xz-group/PiCar/hw/readme.md

The current version of the PiCar does not use a separate motor control board. 
Check documentation for hardware info.
