xz-group/PiCar/src/readme.md

# src - source code

The directory is broadly classified into the following categories:
- arduino
  - contains the low level motor-encoder feedback control
- data
  - contains means to log and analysize data from sensors
- mobile_movement_control
  - contains robust way of controlling the robot using WASD keys (*good place to start for first timers*)
- obsolete
  - code from previous versions of the project that may be used for reference
- pi
  - includes servo GPIO control, camera, and sensor intergration
- pi_arduino_comm
  - contains SPI, Serial and I2C protocols for Raspberry Pi and Arduino
