xz-group/PiCar/hw/chassis/README.md

This folder contains all the CAD files created or used to build the PI Car.

The list of the files are as follows: 
* Bottom Motor Holder
* Camera Post
* Chassis
* Encoder Holder
* Second Level
* Top Motor Holder

Editable .step files can be accessed through GrabCAD (https://grabcad.com/library/pi-car-1).
