xz-group/PiCar/src/arduino_PCB/README.md

Files:
Arduino - 'main' file
LSM9DS1_Resisters, LSM9DS1_Types - LSM9DS1 (6DOF IMU) Library
avrfix, avrfix_config - AVR fixed point library
ddefs - definitions for dshare array
dshare - shared data array
fp - custom fixed point library
imu - custom imu library
servocontrol - servo control library
speed_control - speed control library
spi_comm - SPI communication library
timers - timer library
