xz-group/PiCar/hw/chassis/stl_files/readme.txt

.STL files

These files can be uploaded into a slicing software such as Cura to be 3D printed. 
Files cannot be edited. Send e-mail to wluer@wustl.edu if you would like to receive access to an editable version.
