xz-group/PiCar/docs/readthedocs/index.rst

.. PiCar documentation master file, created by
   sphinx-quickstart on Sat May 19 23:21:28 2018.
   You can adapt this file completely to your liking, but it should at least
   contain the root `toctree` directive.

PiCar Documentation
=================================

PiCar
    A multi-purpose, robotic, lab-scale, open-source, wheeled, autonomous
    research platform created at Washington University in St. Louis

Click on ``Getting Started`` tab on the sidebar, use the search-bar or use any of
the following links to get started.

.. toctree::
   :maxdepth: 3

   chapters/introduction
   chapters/tutorials
   chapters/usage
   chapters/results
   chapters/changelogs
   chapters/contributors
