xz-group/PiCar/hw/motorcontrol/v1.0/README.md

Go to [https://github.com/hgonzale/PiCar/wiki/Breakout-Board](https://github.com/hgonzale/PiCar/wiki/Breakout-Board) for the Breakout Board wiki.
