xz-group/PiCar/src/obsolete/IMU Programs/README

* Developed by Mark Williams
* Created Decemeber 2014 - Updated May 2016

This program will enable your Raspberry Pi to read the values from a gyroscope, accelerometer & magnetometer and convert them to usable angles and heading.
It also includes tilt compensation for compass heading. Utilises both the Complementary and Kalman filters.
Go here for more information;

http://ozzmaker.com/

Run with:
sudo python berryIMU.py

/home/pi/IMU Programs/BerryIMU/python-BerryIMU-gryo-accel-compass/

python berryIMU.py
or python berryIMU-simple.py
