xz-group/PiCar/hw/motorcontrol/v1.0/images/README.md

This directory contains the images used for the breakout board part of the wiki.
