xz-group/PiCar/src/pi/computer_vision/OpticalFlow/videos_papers_plots/ttcPlot.png

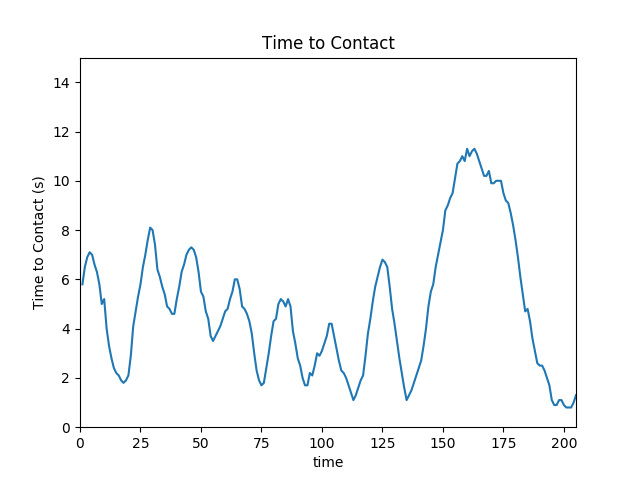
src/pi/computer_vision/OpticalFlow/videos_papers_plots/ttcPlot.png
