xz-group/PiCar/hw/chassis/step_files/Encoder Holder.step

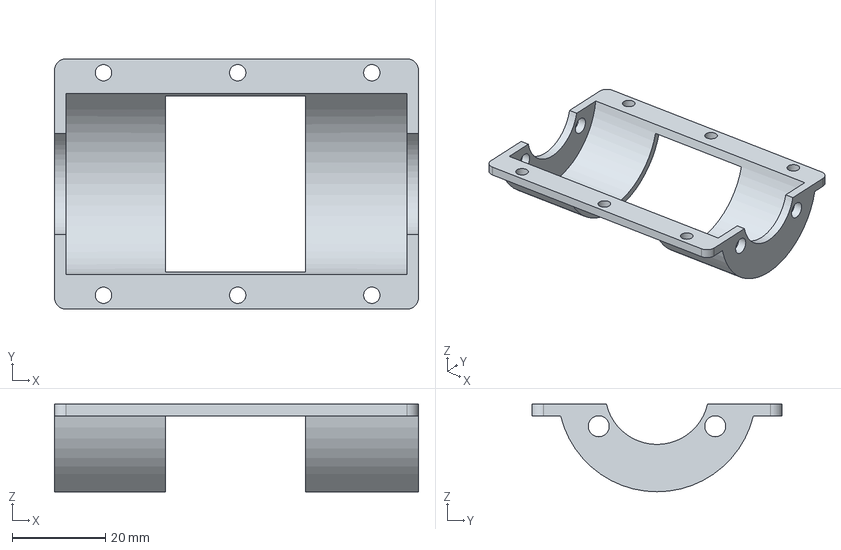
[picture p93: CAD file, 2016-12-12]
hw/chassis/step_files/Encoder Holder.step
78.0 x 53.7 x 18.8 mm
