xz-group/PiCar/hw/chassis/stl_files/Second Level.stl

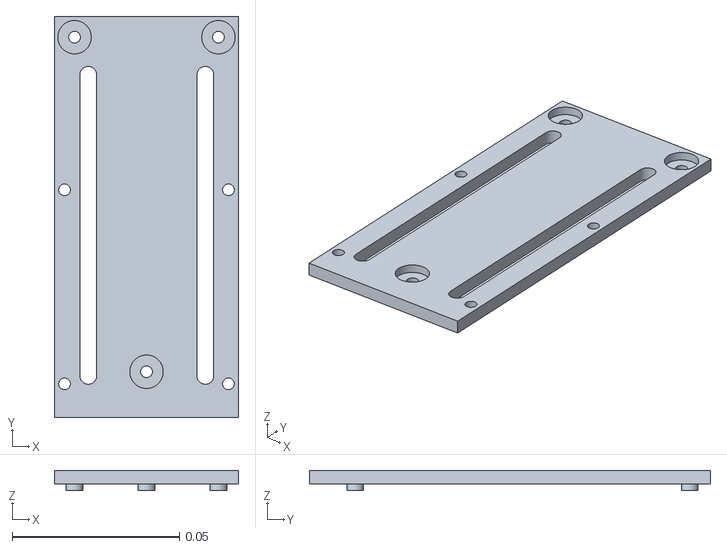
[picture p94: CAD file, 2016-12-09]
hw/chassis/stl_files/Second Level.stl
0.055 x 0.12 x 0.006
