xz-group/PiCar/hw/chassis/step_files/Second Level Plate.step

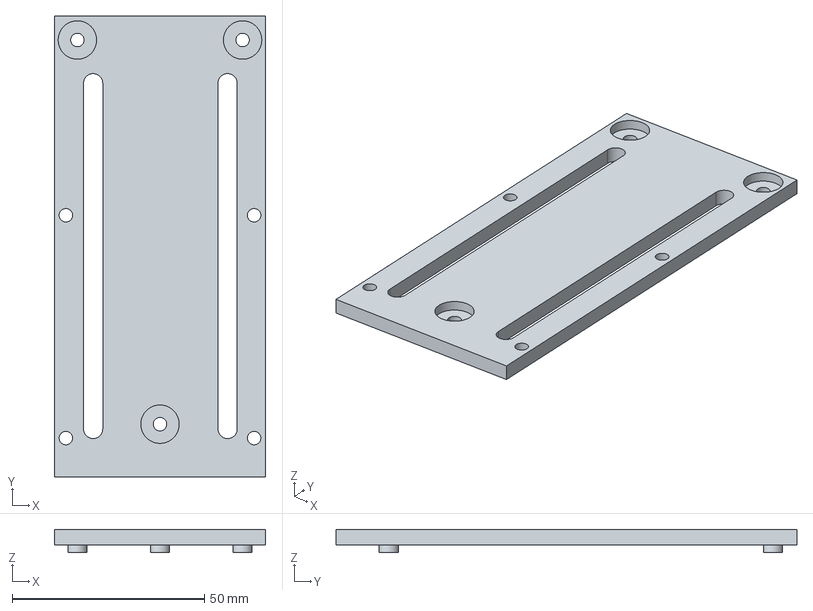
[picture p95: CAD file, 2016-12-12]
hw/chassis/step_files/Second Level Plate.step
55.0 x 120.0 x 6.00 mm
