xz-group/PiCar/hw/chassis/step_files/Bottom Motor Holder.step

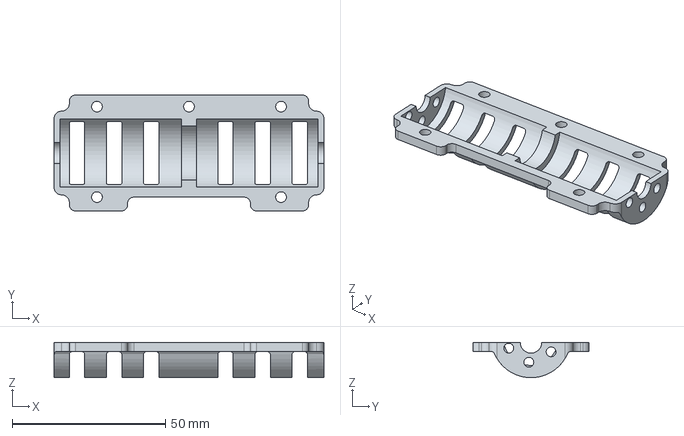
[picture p96: CAD file, 2016-12-12]
hw/chassis/step_files/Bottom Motor Holder.step
88.0 x 37.8 x 11.5 mm
