xz-group/PiCar/hw/chassis/step_files/Top Motor Holder.step

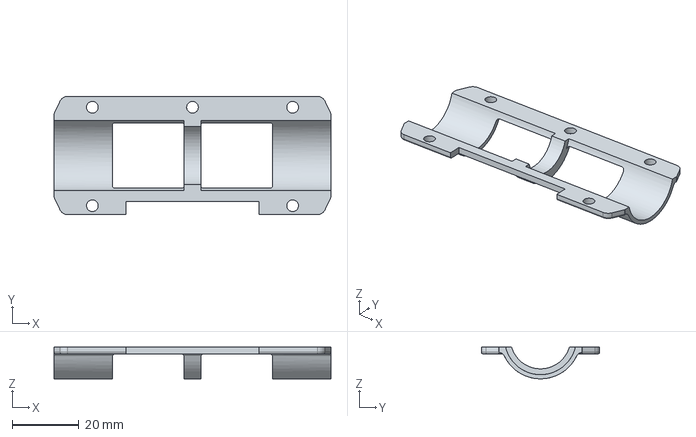
[picture p97: CAD file, 2016-12-12]
hw/chassis/step_files/Top Motor Holder.step
83.0 x 35.5 x 9.50 mm
