xz-group/PiCar/hw/chassis/step_files/Chassis.step

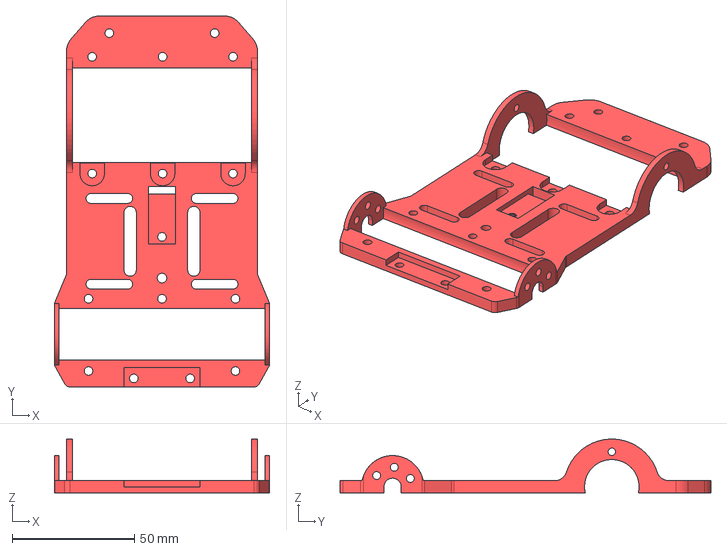
[picture p98: CAD file, 2016-12-12]
hw/chassis/step_files/Chassis.step
88.0 x 151.5 x 22.0 mm
