xz-group/PiCar/hw/chassis/step_files/Camera Post.step

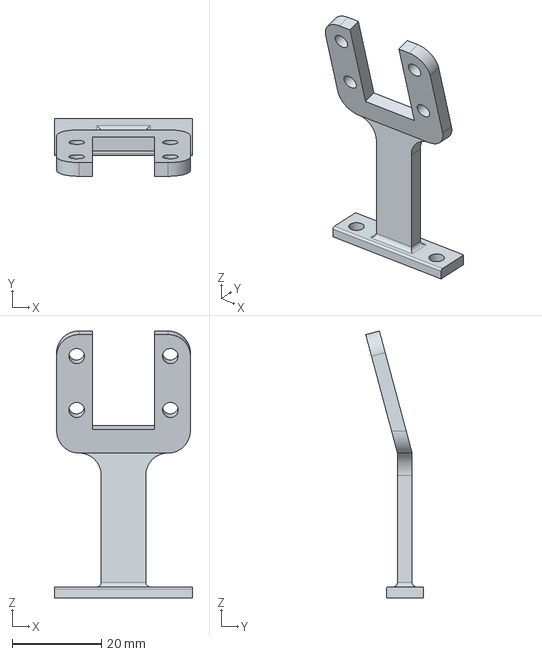
[picture p99: CAD file, 2016-12-12]
hw/chassis/step_files/Camera Post.step
31.0 x 12.9 x 59.9 mm
