xz-group/PiCar/(list of files, cad)

Other CAD files:
hw/chassis/stl_files/Bottom Motor Holder.stl
hw/chassis/stl_files/Camera Post.stl
hw/chassis/stl_files/Chassis.stl
hw/chassis/stl_files/Encoder Holder.stl
hw/chassis/stl_files/Top Motor Holder.stl
hw/obsolete/chassis/stl_files/Bottom Motor Holder.stl
hw/obsolete/chassis/stl_files/Camera Post.stl
hw/obsolete/chassis/stl_files/Chassis.stl
hw/obsolete/chassis/stl_files/Encoder Holder.stl
hw/obsolete/chassis/stl_files/Top Motor Holder.stl
