xz-group/PiCar/hw/chassis/print_screenshots/README

Screenshots of print orientation and settings used to print.
Printer type: Ultimaker Extended 2
Slicing Software: Cura 15.04.3
