xz-group/PiCar/docs/readthedocs/chapters/tutorials.rst

Tutorials
=============

To help you get acquainted with the PiCar platform, the following tutorials
will help you bring to speed about the different components used.

.. toctree::
   :maxdepth: 1

   tutorials/raspberry_pi_basics
   tutorials/arduino_basics
   tutorials/github_basics
   tutorials/linux_basics
   tutorials/python_basics
   tutorials/readthedocs_tut

.. note:: Some of the tutorials will be in the general sense of the components,
          like Linux, etc., while others will specific to the PiCar project.
