xz-group/PiCar/docs/readthedocs/chapters/usage/picar_usage.rst

The Picar Module
#######################

.. autoclass:: picar.device
   :members:

.. autoclass:: picar.sensor
    :inherited-members:

.. autoclass:: picar.pmucounter
    :inherited-members:

.. autoclass:: picar.IMU
    :inherited-members:

.. autoclass:: picar.LiDar
    :inherited-members:

.. autoclass:: picar.Camera
    :inherited-members:

.. autoclass:: picar.Timer
    :members:

.. autoclass:: picar.Killer
    :members:

.. autofunction:: picar.pre_exec

.. autofunction:: picar.filenames

.. autofunction:: picar.getCamera

.. autofunction:: picar.getSensor

.. autofunction:: picar.getSensorAndCamera
