xz-group/PiCar/docs/readthedocs/chapters/usage.rst

Usage
=============

The project is split into three parts:

.. toctree::
   :maxdepth: 2

   usage/mechanical
   usage/electronics
   usage/software
   usage/datasheet
   usage/picar_usage
