xz-group/PiCar/hw/chassis/print_screenshots/BottomMotorHolderPrintScreenshot.png

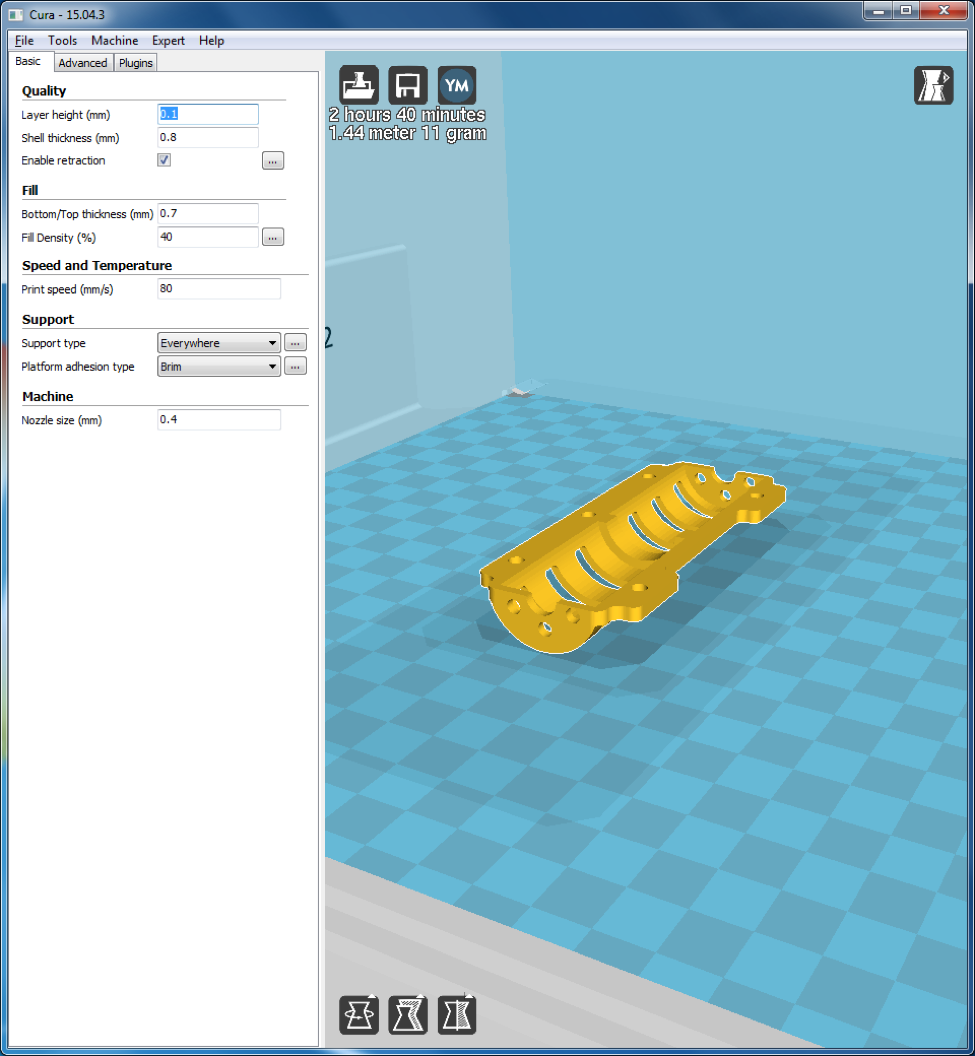
hw/chassis/print_screenshots/BottomMotorHolderPrintScreenshot.png
