xz-group/PiCar/hw/chassis/print_screenshots/CameraPostPrintScreenshot.png

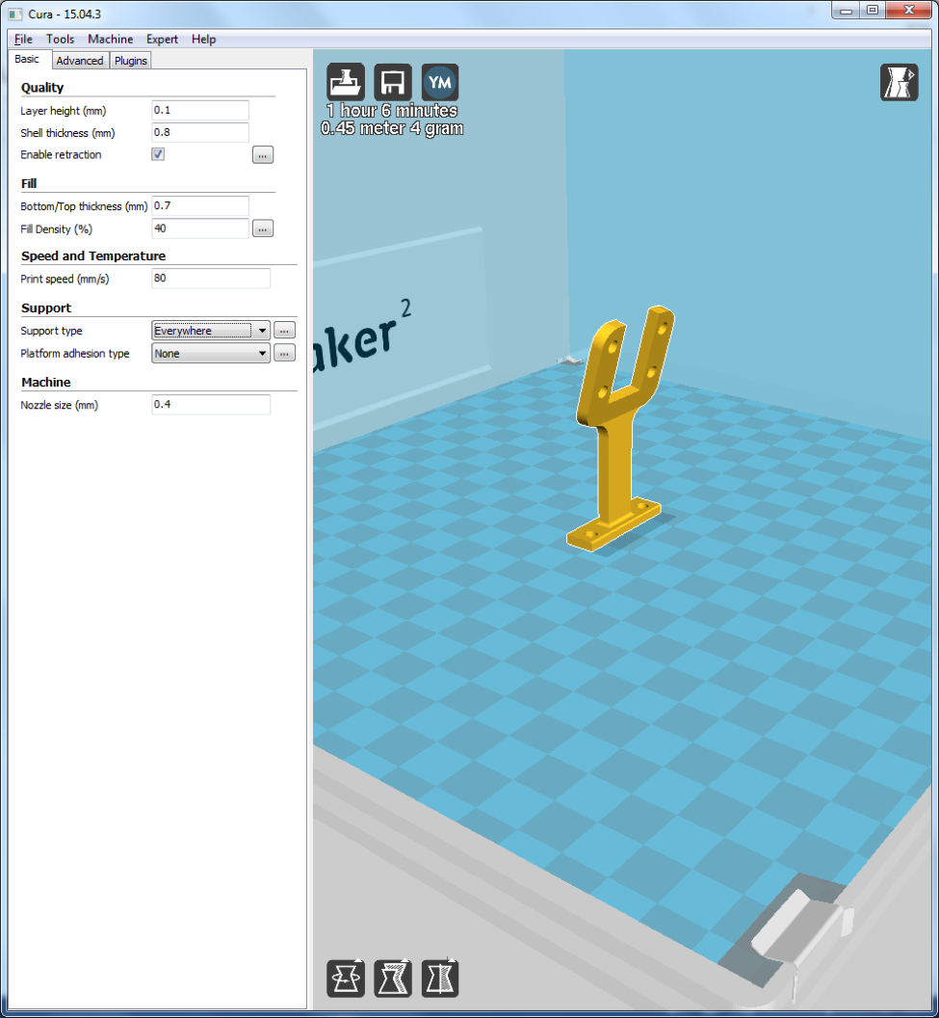
hw/chassis/print_screenshots/CameraPostPrintScreenshot.png
