xz-group/PiCar/hw/chassis/print_screenshots/ChassisPrintScreenshot.png

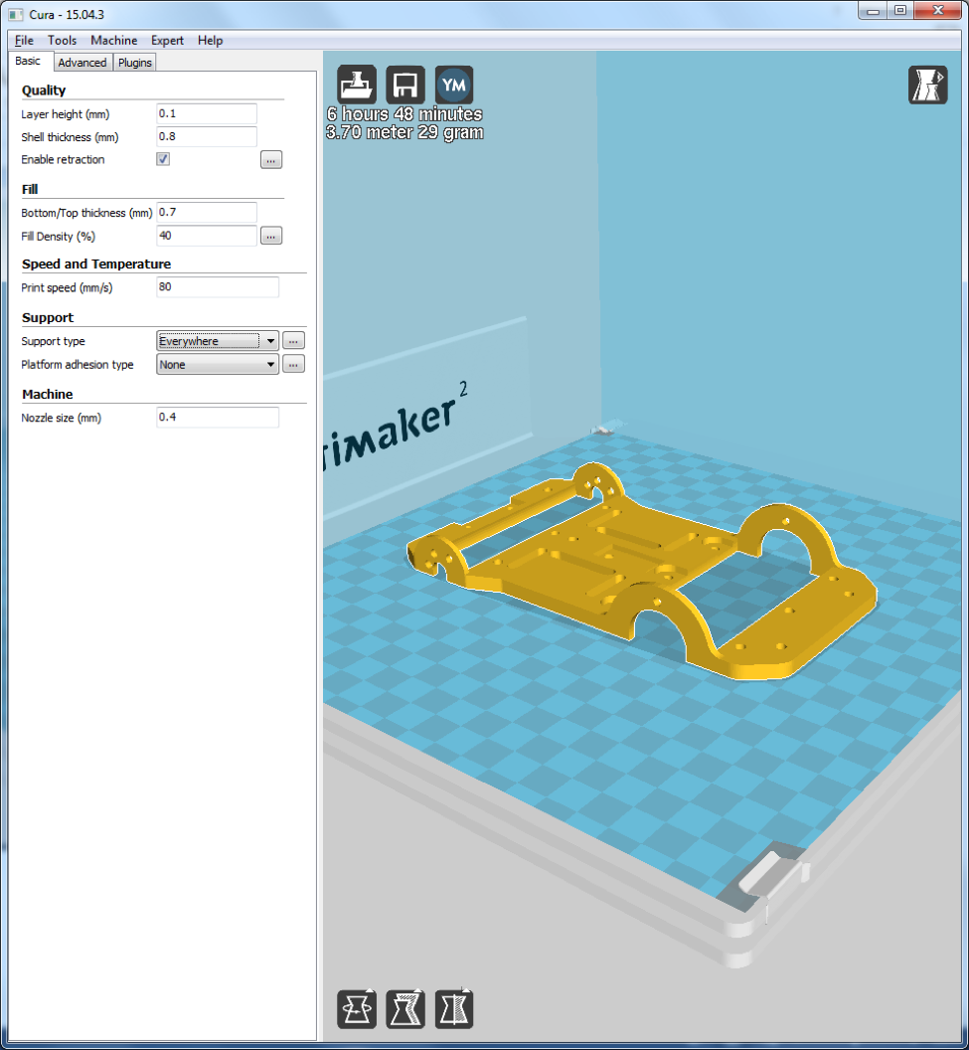
hw/chassis/print_screenshots/ChassisPrintScreenshot.png
