xz-group/PiCar/hw/chassis/print_screenshots/EncoderHolderPrintScreenshot.png

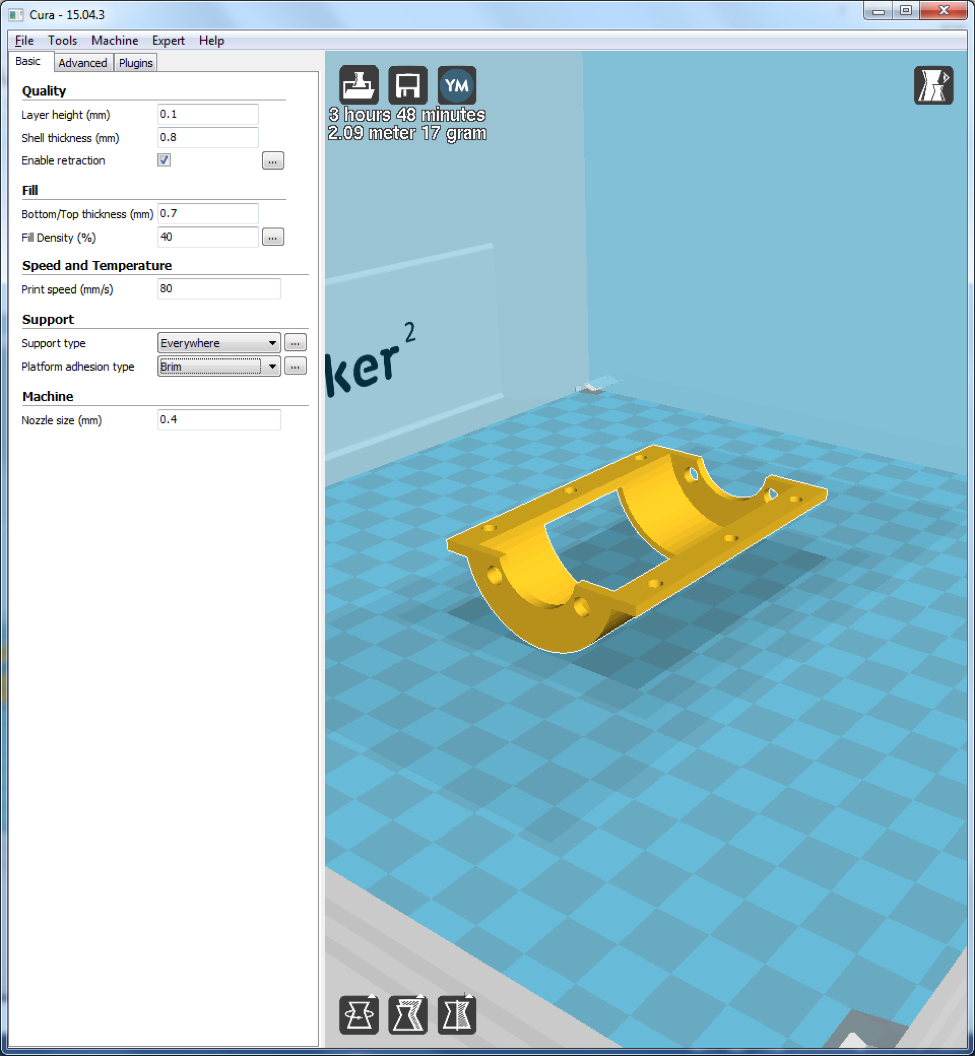
hw/chassis/print_screenshots/EncoderHolderPrintScreenshot.png
