xz-group/PiCar/hw/chassis/print_screenshots/SecondLevelPrintScreenshot.png

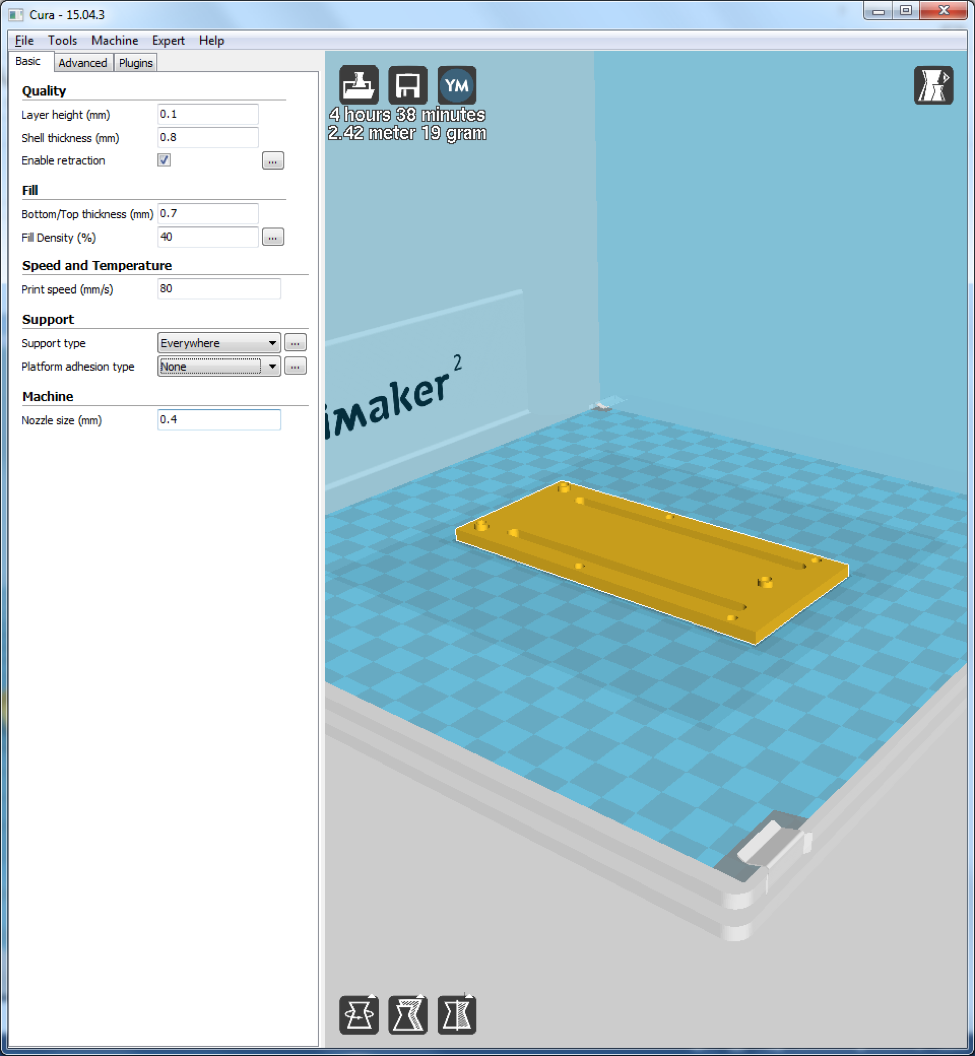
hw/chassis/print_screenshots/SecondLevelPrintScreenshot.png
