xz-group/PiCar/docs/readthedocs/chapters/results.rst

Results
=============

The PiCar platform has been used in many research project.
This page gives a comprehensive list of different results that were achieved.

.. toctree::
   :maxdepth: 1

   results/imu_autonomous_navigation
   results/power_management
   results/optical_flow
   results/mobile_movement_control
   results/obstacle_avoidance
