xz-group/PiCar/src/data/data_analysis/Display/PapaParse-4.5.0/tests/sample.csv

A | B | C
X | Y | Z
