xz-group/PiCar/src/data/data_analysis/Display/PapaParse-4.5.0/tests/verylong-sample.csv

placeholder | meaning of life | TLD
Lorem ipsum dolor sit | 42 | ABC
Etiam a dolor vitae est vestibulum | 84 | DEF
Lorem ipsum dolor sit | 42 | ABC
Etiam a dolor vitae est vestibulum | 84 | DEF
Etiam a dolor vitae est vestibulum | 84 | DEF
Lorem ipsum dolor sit | 42 | ABC
Lorem ipsum dolor sit | 42 | ABC
Etiam a dolor vitae est vestibulum | 84 | DEF
Lorem ipsum dolor sit | 42 | ABC
Etiam a dolor vitae est vestibulum | 84 | DEF
Lorem ipsum dolor sit | 42 | ABC
Etiam a dolor vitae est vestibulum | 84 | DEF
Etiam a dolor vitae est vestibulum | 84 | DEF
Lorem ipsum dolor sit | 42 | ABC
Etiam a dolor vitae est vestibulum | 84 | DEF
Lorem ipsum dolor sit | 42 | ABC
Lorem ipsum dolor sit | 42 | ABC
Etiam a dolor vitae est vestibulum | 84 | DEF
Etiam a dolor vitae est vestibulum | 84 | DEF
Lorem ipsum dolor sit | 42 | ABC
Etiam a dolor vitae est vestibulum | 84 | DEF
Etiam a dolor vitae est vestibulum | 84 | DEF
Lorem ipsum dolor sit | 42 | ABC
Etiam a dolor vitae est vestibulum | 84 | DEF
Lorem ipsum dolor sit | 42 | ABC
Lorem ipsum dolor sit | 42 | ABC
Lorem ipsum dolor sit | 42 | ABC
Etiam a dolor vitae est vestibulum | 84 | DEF
Etiam a dolor vitae est vestibulum | 84 | DEF
Etiam a dolor vitae est vestibulum | 84 | DEF
Etiam a dolor vitae est vestibulum | 84 | DEF
Etiam a dolor vitae est vestibulum | 84 | DEF
Lorem ipsum dolor sit | 42 | ABC
Lorem ipsum dolor sit | 42 | ABC
Lorem ipsum dolor sit | 42 | ABC
Etiam a dolor vitae est vestibulum | 84 | DEF
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
Lorem ipsum dolor sit | 42 | ABC
Lorem ipsum dolor sit | 42 | ABC
Etiam a dolor vitae est vestibulum | 84 | DEF
Lorem ipsum dolor sit | 42 | ABC
Lorem ipsum dolor sit | 42 | ABC
Etiam a dolor vitae est vestibulum | 84 | DEF
Lorem ipsum dolor sit | 42
Lorem ipsum dolor sit | 42 | ABC
