xz-group/PiCar/docs/readthedocs/chapters/changelogs.rst

Changelogs
=============

v2.0 (`latest <https://github.com/xz-group/PiCar>`_)
  * Changed chassis design to make PiCar more robust
  * Added single encoder with DC motor for closed loop
  * Incorporated LIDAR and IMU
  * Added comprehensive ReadtheDocs documentation

v1.0 (`Github <https://github.com/xz-group/PiCar/tree/v1.0>`_)
  * Designed and built entirely 3D printable chassis
  * Used brushless DC motor, ESC and servo for steering and driving
  * Designed and assembled PCB for power management, reading hall effect
    sensors and IMU data
  * Used camera with optical flow computer vision algorithm for tracking
