xz-group/PiCar/hw/motorcontrol/v2.1/motorcontrol-diagrams.pdf

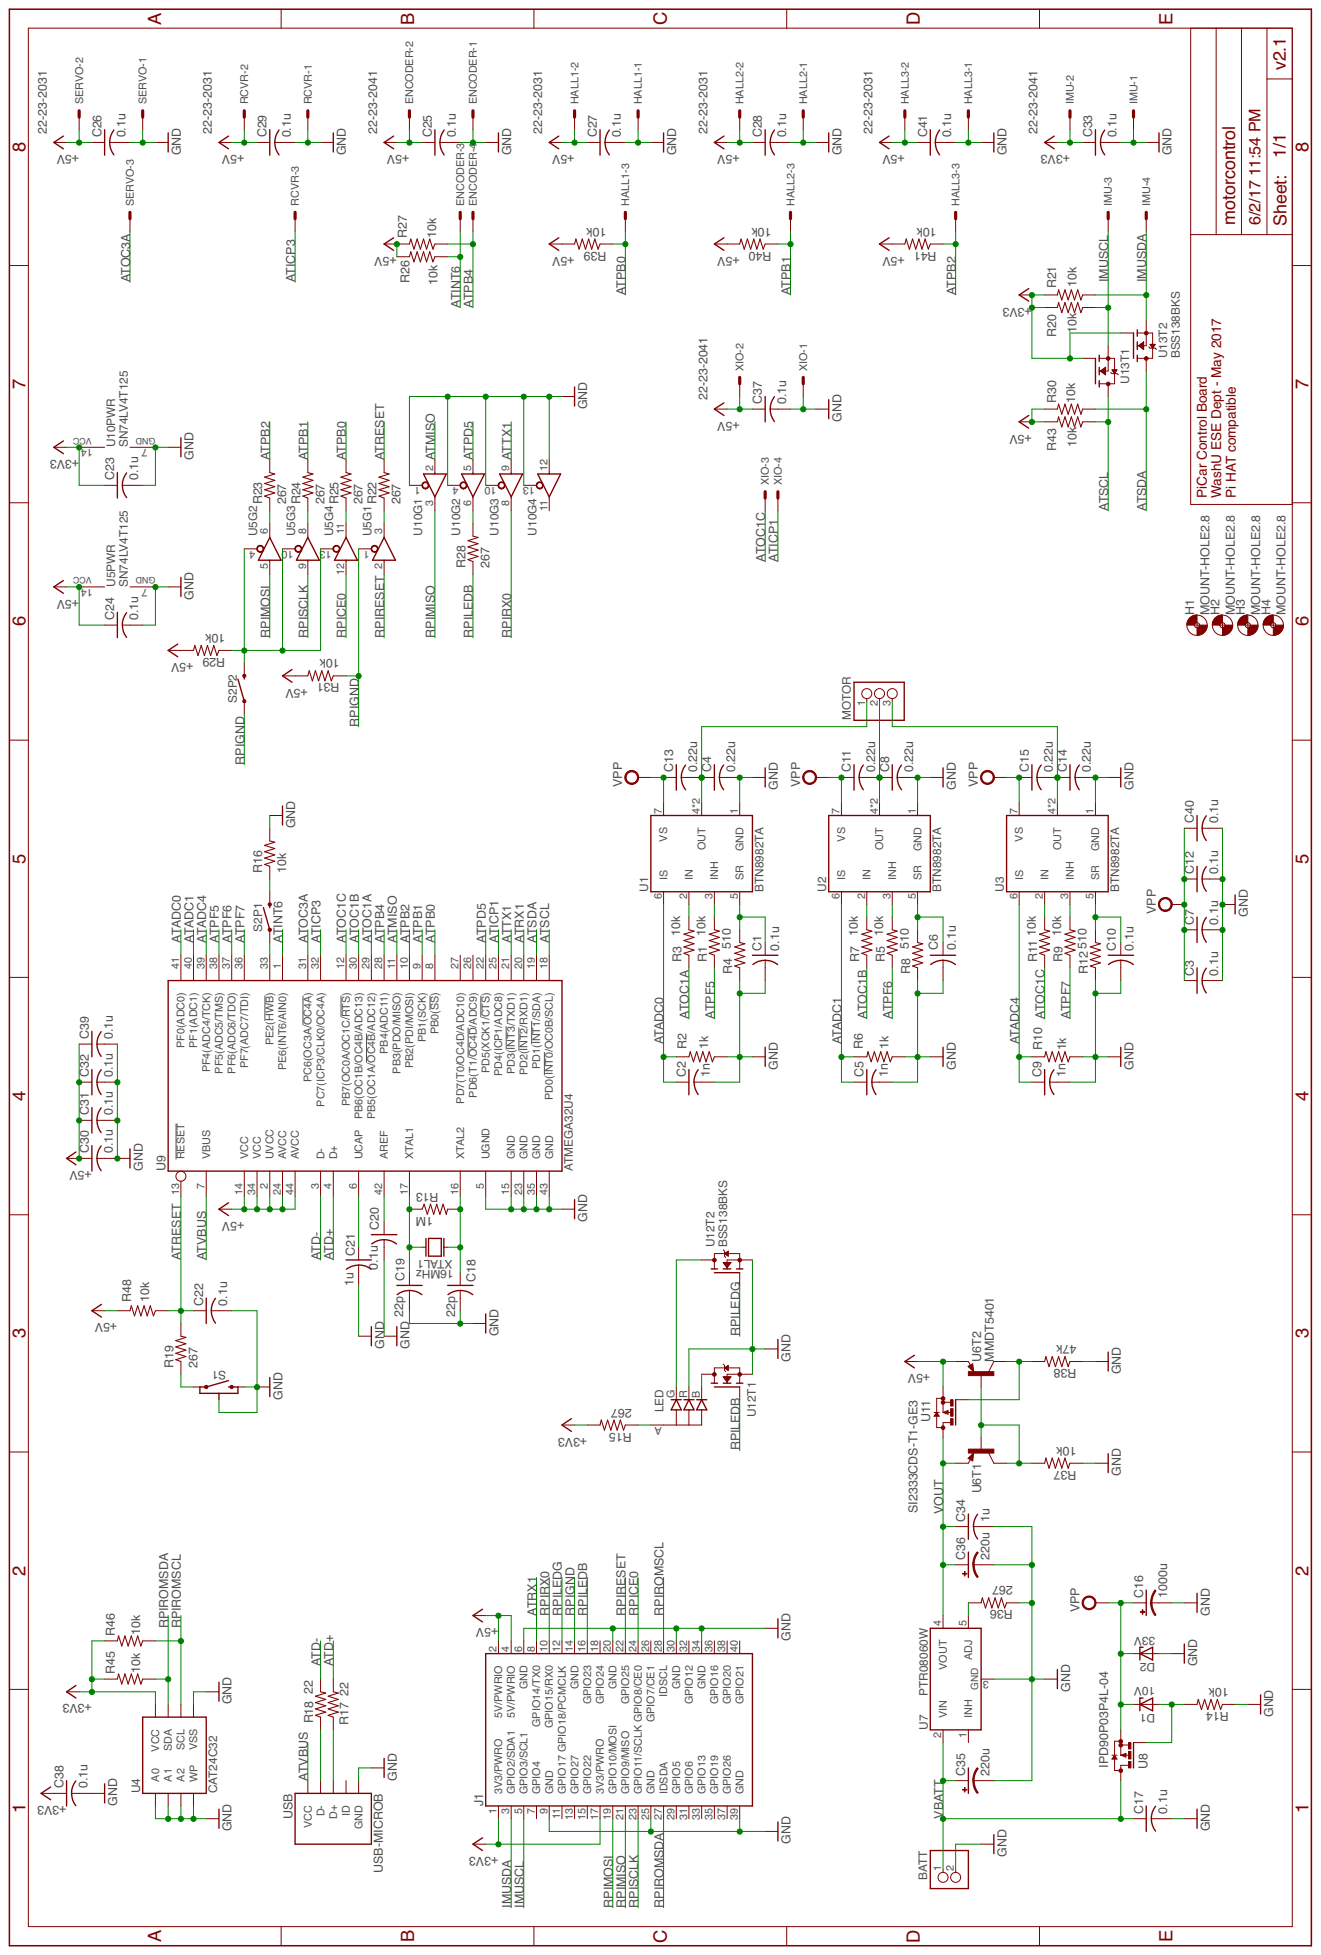
[picture p106: page 1]

PiCar Control Board WashU ESE Dept - May 2017 Pi HAT compatible v2.1 motorcontrol 6/2/17 11:54 PM

MOUNT-HOLE2.8 MOUNT-HOLE2.8

PF0(ADC0) 41 PF1(ADC1) 40 PF4(ADC4/TCK) 39 PF5(ADC5/TMS) 38 PF6(ADC6/TDO) 37 PF7(ADC7/TDI) 36 PE6(INT6/AIN0) 1

PB3(PDO/MISO) 11 PB2(PDI/MOSI) 10 PB1(SCK) 9 PB0(SS) 8 PD7(T0/OC4D/ADC10) 27 PD6(T1/OC4D/ADC9) 26 PD5(XCK1/CTS) 22 PD4(ICP1/ADC8) 25 PD3(INT3/TXD1) 21 PD2(INT2/RXD1) 20 PD1(INT1/SDA) 19 PD0(INT0/OC0B/SCL) 18

ATD- ATD- ATD+ ATD+

VCC A0A1A2 SCL WP VSS

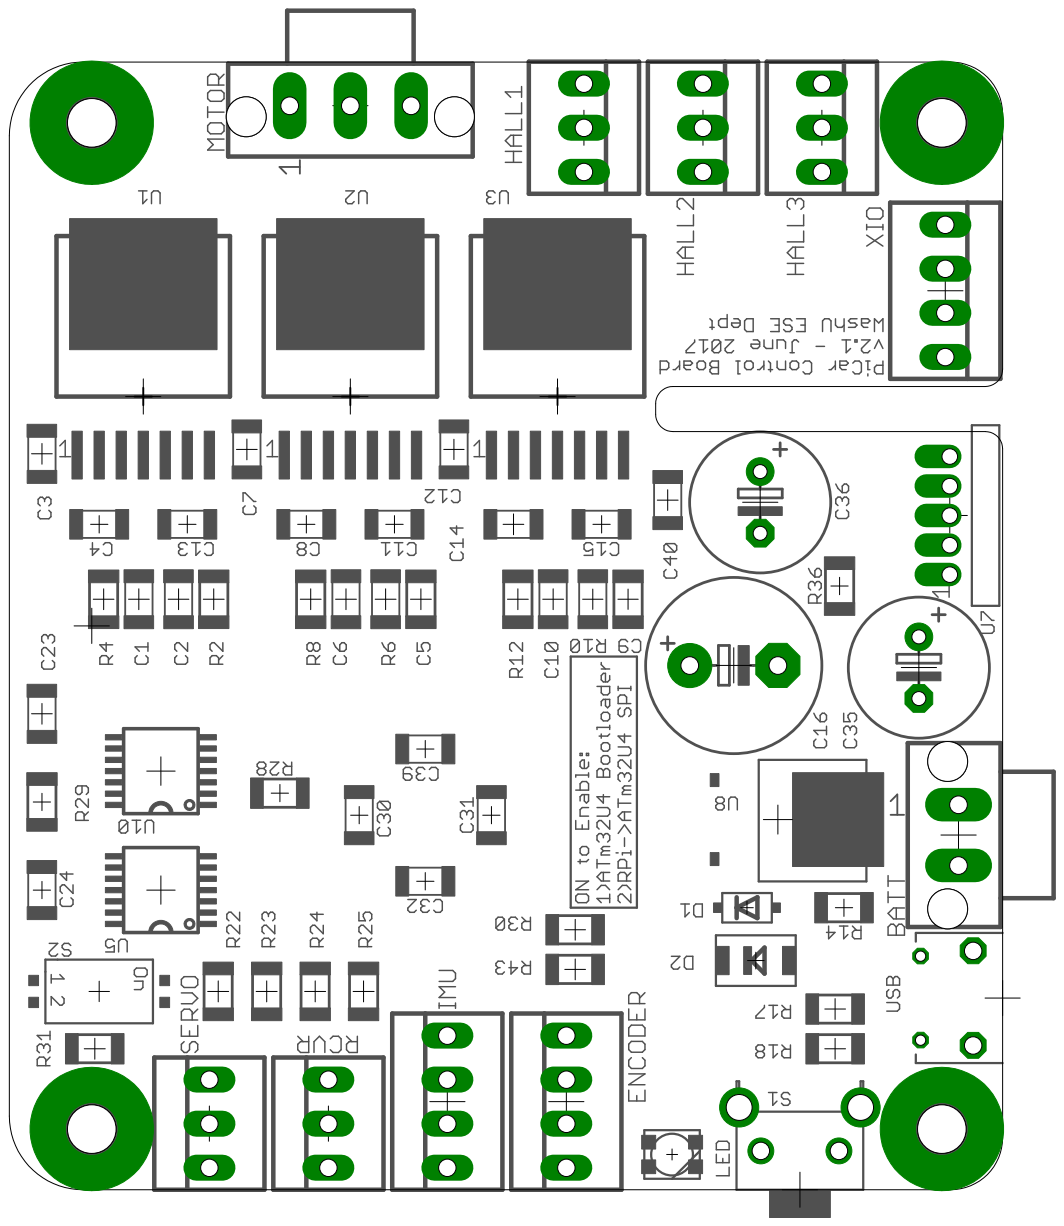
[picture p107: page 2]

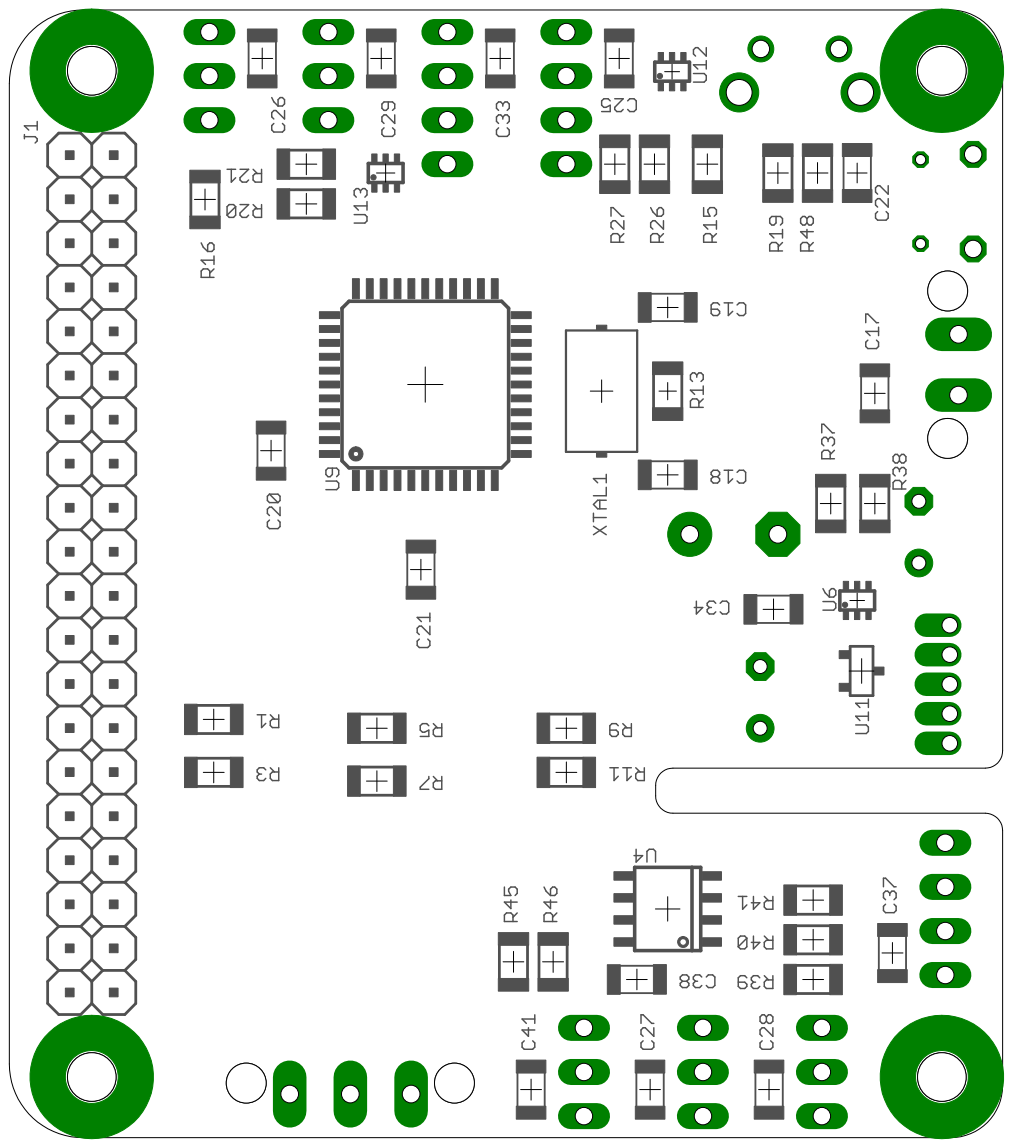
[picture p108: page 3]
