xz-group/PiCar/hw/motorcontrol/v2.0/sch.pdf

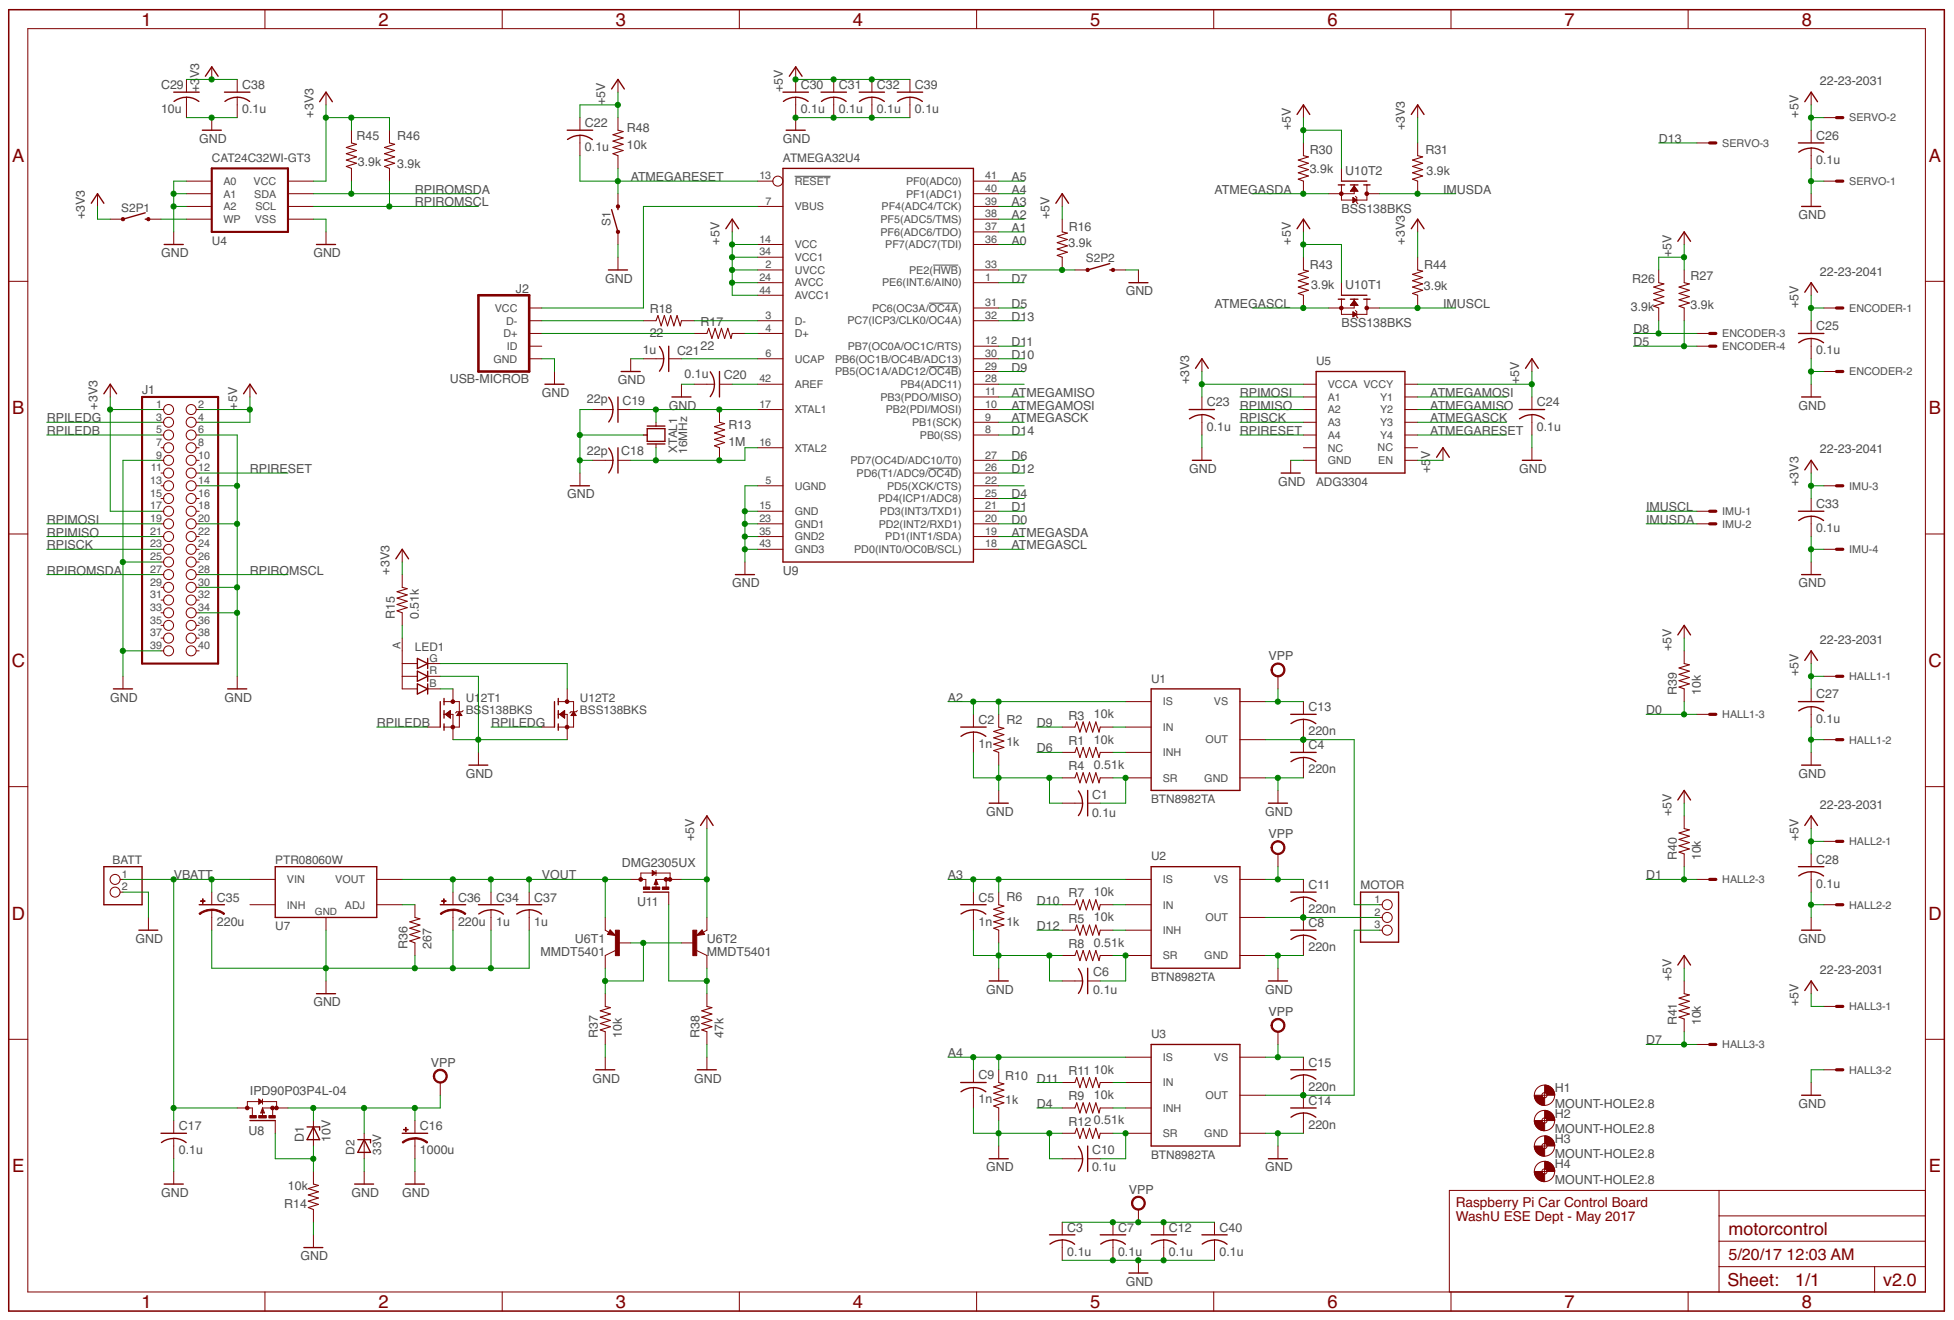
[picture p109: page 1]

Raspberry Pi Car Control Board
WashU ESE Dept - May 2017
