xz-group/PiCar/hw/motorcontrol/v2.0/brd_bottom.pdf

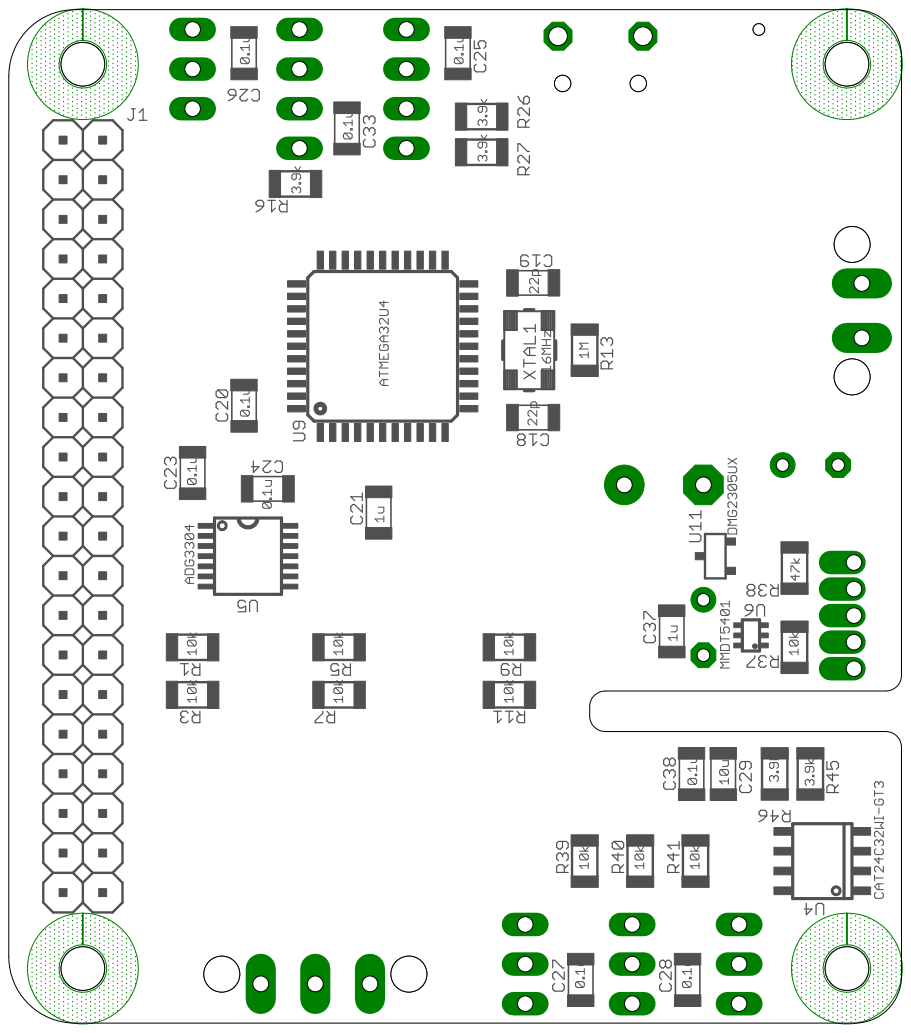
[picture p110: page 1]
