xz-group/PiCar/hw/motorcontrol/v2.0/brd_top.pdf

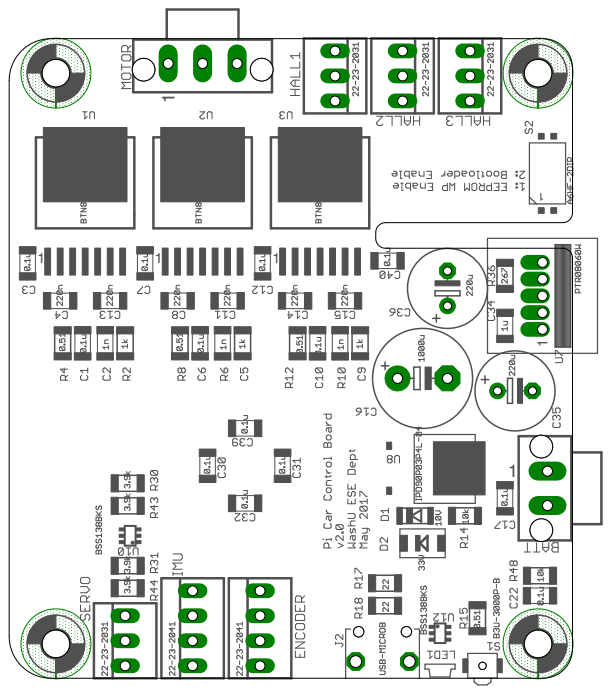
[picture p111: page 1]
