xz-group/PiCar/hw/motorcontrol/v2.1/motorcontrol.brd

## EAGLE design hw/motorcontrol/v2.1/motorcontrol.brd (2018-01-17)

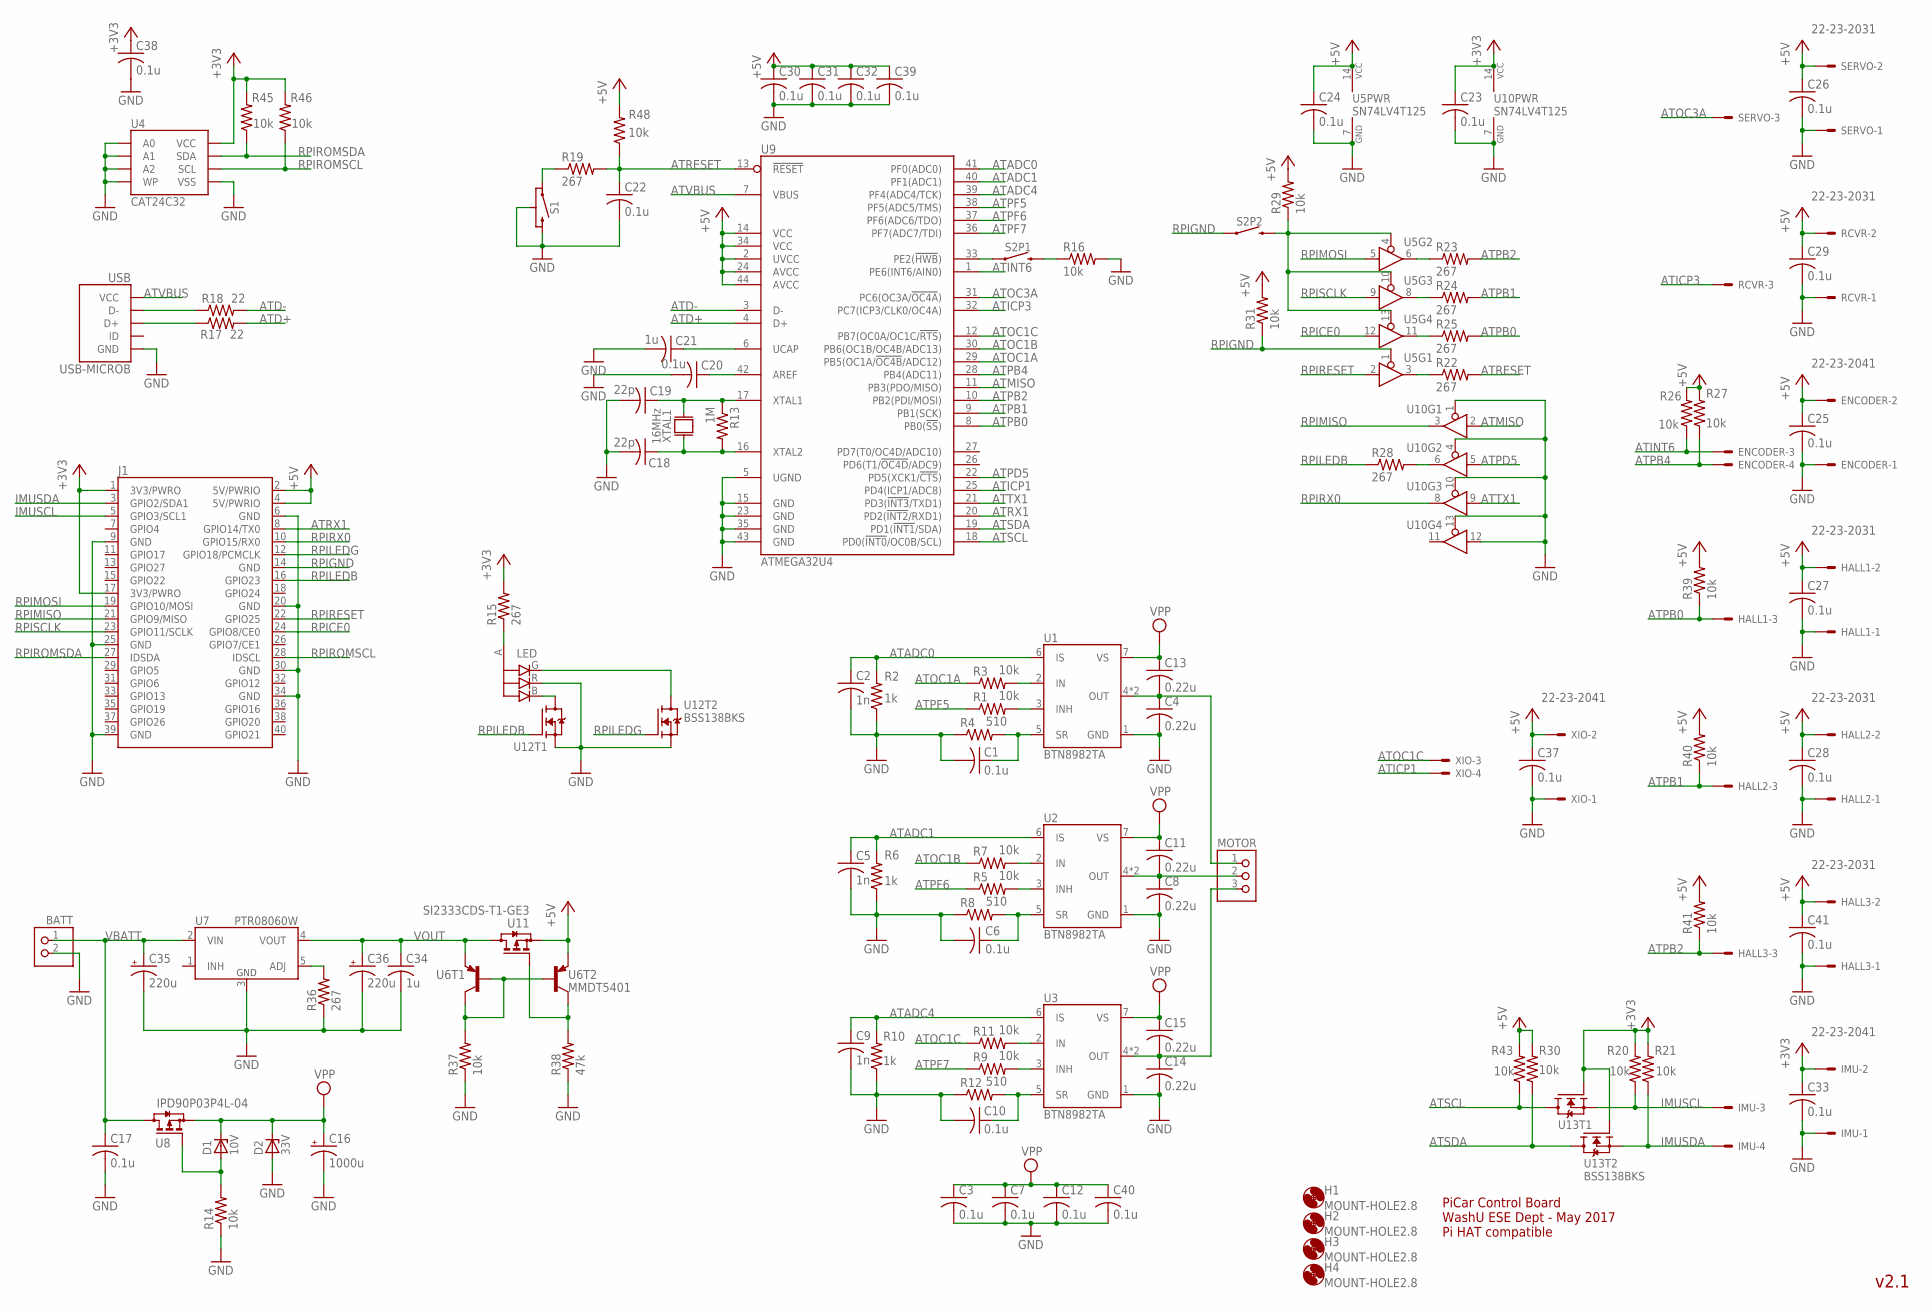
[picture p112: schematic motorcontrol.sch]

Parts:
BATT: ULTRAFIT_2CIRCVCLIP; ULTRAFIT_2CIRC_VERTCLIP
C1, C3, C6, C7, C10, C12, C17, C20, C22, C23, C24, C25, C26, C27, C28, C29, C30, C31, C32, C33, C37, C38, C39, C40, C41: 0.1u; C1206
C2, C5, C9: 1n; C1206
C4, C8, C11, C13, C14, C15: 0.22u; C1206
C16: 1000u; E5-10,5
C18, C19: 22p; C1206
C21, C34: 1u; C1206
C35, C36: 220u; E3,5-8
D1: 10V; SOD123
D2: 33V; SMA
ENCODER: 22-23-2041
H1, H2, H3, H4: MOUNT-HOLE2.8; 2,8
HALL1, HALL2, HALL3: 22-23-2031
IMU: 22-23-2041
J1: RPIHEADER_2.54-SMD; RPI_SMD
LED: LED_3COLOR_COMMONA1411; 150141M173100
MOTOR: ULTRAFIT_3CIRCVCLIP; ULTRAFIT_3CIRC_VERTCLIP
R1, R3, R5, R7, R9, R11, R14, R16, R20, R21, R26, R27, R29, R30, R31, R37, R39, R40, R41, R43, R45, R46, R48: 10k; R1206
R2, R6, R10: 1k; R1206
R4, R8, R12: 510; R1206
R13: 1M; R1206
R15, R19, R22, R23, R24, R25, R28, R36: 267; R1206
R17, R18: 22; R1206
R38: 47k; R1206
RCVR: 22-23-2031
S1: SWITCH-GND; B3F-312X
S2: A6HF-2DIP
SERVO: 22-23-2031
U1, U2, U3: BTN8982TA; TO263-7
U4: CAT24C32; SOIC8
U5, U10: SN74LV4T125; TSSOP14
U6: MMDT5401; SOT363
U7: PTR08060W; EDP_MODULE
U8: IPD90P03P4L-04; TO252-3-11
U9: ATMEGA32U4; TQFP44
U11: SI2333CDS-T1-GE3; SOT23-3
U12, U13: BSS138BKS; SOT363
USB: USB-MICROB; FCI-10103594-0001LF
XIO: 22-23-2041
XTAL1: 16MHz; ABLS7M2

Connections:
+3V3: C23.1, C33.1, C38.1, IMU.2, J1.1 (3V3/PWRO), J1.17 (3V3/PWRO), R15.2, R20.2, R21.2, R45.2, R46.2, U4.8 (VCC), U10.14 (VCC), U13.2 (G), U13.5 (G)
+5V: C24.1, C25.1, C26.1, C27.1, C28.1, C29.1, C30.1, C31.1, C32.1, C37.1, C39.1, C41.1, ENCODER.2, HALL1.2, HALL2.2, HALL3.2, J1.2 (5V/PWRIO), J1.4 (5V/PWRIO), R26.2, R27.2, R29.2, R30.2, R31.2, R39.2, R40.2, R41.2, R43.2, R48.2, RCVR.2, SERVO.2, U5.14 (VCC), U6.4 (E), U9.2 (UVCC), U9.14 (VCC), U9.24 (AVCC), U9.34 (VCC), U9.44 (AVCC), U11.2 (S), XIO.2
ATADC0: C2.1, R2.2, U1.6 (IS), U9.41 (PF0(ADC0))
ATADC1: C5.1, R6.2, U2.6 (IS), U9.40 (PF1(ADC1))
ATADC4: C9.1, R10.2, U3.6 (IS), U9.39 (PF4(ADC4/TCK))
ATD+: R17.2, U9.4 (D+)
ATD-: R18.2, U9.3 (D-)
ATICP1: U9.25 (PD4(ICP1/ADC8)), XIO.4
ATICP3: RCVR.3, U9.32 (PC7(ICP3/CLK0/OC4A))
ATINT6: ENCODER.3, R26.1, U9.1 (PE6(INT6/AIN0))
ATMISO: U9.11 (PB3(PDO/MISO)), U10.2 (I)
ATOC1A: R3.1, U9.29 (PB5(OC1A/!OC4B!/ADC12))
ATOC1B: R7.1, U9.30 (PB6(OC1B/OC4B/ADC13))
ATOC1C: R11.1, U9.12 (PB7(OC0A/OC1C/!RTS!)), XIO.3
ATOC3A: SERVO.3, U9.31 (PC6(OC3A/!OC4A!))
ATPB0: HALL1.3, R25.2, R39.1, U9.8 (PB0(!SS!))
ATPB1: HALL2.3, R24.2, R40.1, U9.9 (PB1(SCK))
ATPB2: HALL3.3, R23.2, R41.1, U9.10 (PB2(PDI/MOSI))
ATPB4: ENCODER.4, R27.1, U9.28 (PB4(ADC11))
ATPD5: U9.22 (PD5(XCK1/!CTS!)), U10.5 (I)
ATPF5: R1.1, U9.38 (PF5(ADC5/TMS))
ATPF6: R5.1, U9.37 (PF6(ADC6/TDO))
ATPF7: R9.1, U9.36 (PF7(ADC7/TDI))
ATRESET: C22.1, R19.2, R22.2, R48.1, U9.13 (!RESET!)
ATRX1: J1.8 (GPIO14/TX0), U9.20 (PD2(!INT2!/RXD1))
ATSCL: R43.1, U9.18 (PD0(!INT0!/OC0B/SCL)), U13.6 (D)
ATSDA: R30.1, U9.19 (PD1(!INT1!/SDA)), U13.3 (D)
ATTX1: U9.21 (PD3(!INT3!/TXD1)), U10.9 (I)
ATVBUS: U9.7 (VBUS), USB.1 (VCC)
GND: BATT.2, C1.2, C2.2, C3.2, C4.2, C5.2, C6.2, C7.2, C8.2, C9.2, C10.2, C12.2, C14.2, C16.-, C17.2, C18.2, C19.2, C20.2, C21.2, C22.2, C23.2, C24.2, C25.2, C26.2, C27.2, C28.2, C29.2, C30.2, C31.2, C32.2, C33.2, C34.2, C35.-, C36.-, C37.2, C38.2, C39.2, C40.2, C41.2, D2.A, ENCODER.1, HALL1.1, HALL2.1, HALL3.1, IMU.1, J1.6 (GND), J1.9 (GND), J1.20 (GND), J1.25 (GND), J1.30 (GND), J1.34 (GND), J1.39 (GND), LED.R, R2.1, R4.1, R6.1, R8.1, R10.1, R12.1, R14.1, R16.2, R36.1, R37.1, R38.1, RCVR.1, S1.2, S1.3 (GND), S1.4 (GND), SERVO.1, U1.1 (GND), U2.1 (GND), U3.1 (GND), U4.1 (A0), U4.2 (A1), U4.3 (A2), U4.4 (VSS), U4.7 (WP), U5.7 (GND), U7.3 (GND), U9.5 (UGND), U9.15 (GND), U9.23 (GND), U9.35 (GND), U9.43 (GND), U10.1 (OE), U10.4 (OE), U10.7 (GND), U10.10 (OE), U10.12 (I), U10.13 (OE), U12.1 (S), U12.4 (S), USB.5 (GND), USB.GND1 (GND), USB.GND2 (GND), USB.GND3 (GND), USB.GND4 (GND), XIO.1
IMUSCL: IMU.3, J1.5 (GPIO3/SCL1), R20.1, U13.1 (S)
IMUSDA: IMU.4, J1.3 (GPIO2/SDA1), R21.1, U13.4 (S)
unnamed: R1.2, U1.3 (INH)
unnamed: R38.2, U6.3 (C), U11.1 (G)
unnamed: C19.1, R13.1, U9.17 (XTAL1), XTAL1.2
unnamed: R3.2, U1.2 (IN)
unnamed: C6.1, R8.2, U2.5 (SR)
unnamed: R5.2, U2.3 (INH)
unnamed: C18.1, R13.2, U9.16 (XTAL2), XTAL1.1
unnamed: S2.P1.1 (1), U9.33 (PE2(!HWB!))
unnamed: R7.2, U2.2 (IN)
unnamed: LED.A, R15.1
unnamed: R28.2, U10.6 (O)
unnamed: R16.1, S2.P1.2 (2)
unnamed: R37.2, U6.2 (B), U6.5 (B), U6.6 (C)
unnamed: LED.B, U12.6 (D)
unnamed: R9.2, U3.3 (INH)
unnamed: R18.1, USB.2 (D-)
unnamed: R11.2, U3.2 (IN)
unnamed: R22.1, U5.3 (O)
unnamed: C20.1, U9.42 (AREF)
unnamed: C21.1, U9.6 (UCAP)
unnamed: D1.A, R14.2, U8.1 (G)
unnamed: LED.G, U12.3 (D)
unnamed: R19.1, S1.1
unnamed: C1.1, R4.2, U1.5 (SR)
unnamed: R17.1, USB.3 (D+)
unnamed: C10.1, R12.2, U3.5 (SR)
unnamed: R23.1, U5.6 (O)
unnamed: R24.1, U5.8 (O)
unnamed: R25.1, U5.11 (O)
unnamed: R36.2, U7.5 (ADJ)
OUT1: C4.1, C13.2, MOTOR.1, U1.4 (OUT), U1.8 (OUT)
OUT2: C8.1, C11.2, MOTOR.2, U2.4 (OUT), U2.8 (OUT)
OUT3: C14.1, C15.2, MOTOR.3, U3.4 (OUT), U3.8 (OUT)
RPICE0: J1.24 (GPIO8/CE0), U5.12 (I)
RPIGND: J1.14 (GND), R31.1, S2.P2.1 (1), U5.1 (OE)
RPILEDB: J1.16 (GPIO23), R28.1, U12.2 (G)
RPILEDG: J1.12 (GPIO18/PCMCLK), U12.5 (G)
RPIMISO: J1.21 (GPIO9/MISO), U10.3 (O)
RPIMOSI: J1.19 (GPIO10/MOSI), U5.5 (I)
RPIRESET: J1.22 (GPIO25), U5.2 (I)
RPIROMSCL: J1.28 (IDSCL), R46.1, U4.6 (SCL)
RPIROMSDA: J1.27 (IDSDA), R45.1, U4.5 (SDA)
RPIRX0: J1.10 (GPIO15/RX0), U10.8 (O)
RPISCLK: J1.23 (GPIO11/SCLK), U5.9 (I)
U5OE: R29.1, S2.P2.2 (2), U5.4 (OE), U5.10 (OE), U5.13 (OE)
VBATT: BATT.1, C17.1, C35.+, U7.2 (VIN), U8.2 (D)
VOUT: C34.1, C36.+, U6.1 (E), U7.4 (VOUT), U11.3 (D)
VPP: C3.1, C7.1, C11.1, C12.1, C13.1, C15.1, C16.+, C40.1, D1.C, D2.C, U1.7 (VS), U2.7 (VS), U3.7 (VS), U8.3 (S)

Notes on the sheet:
PiCar Control Board WashU ESE Dept - May 2017 Pi HAT compatible
v2.1

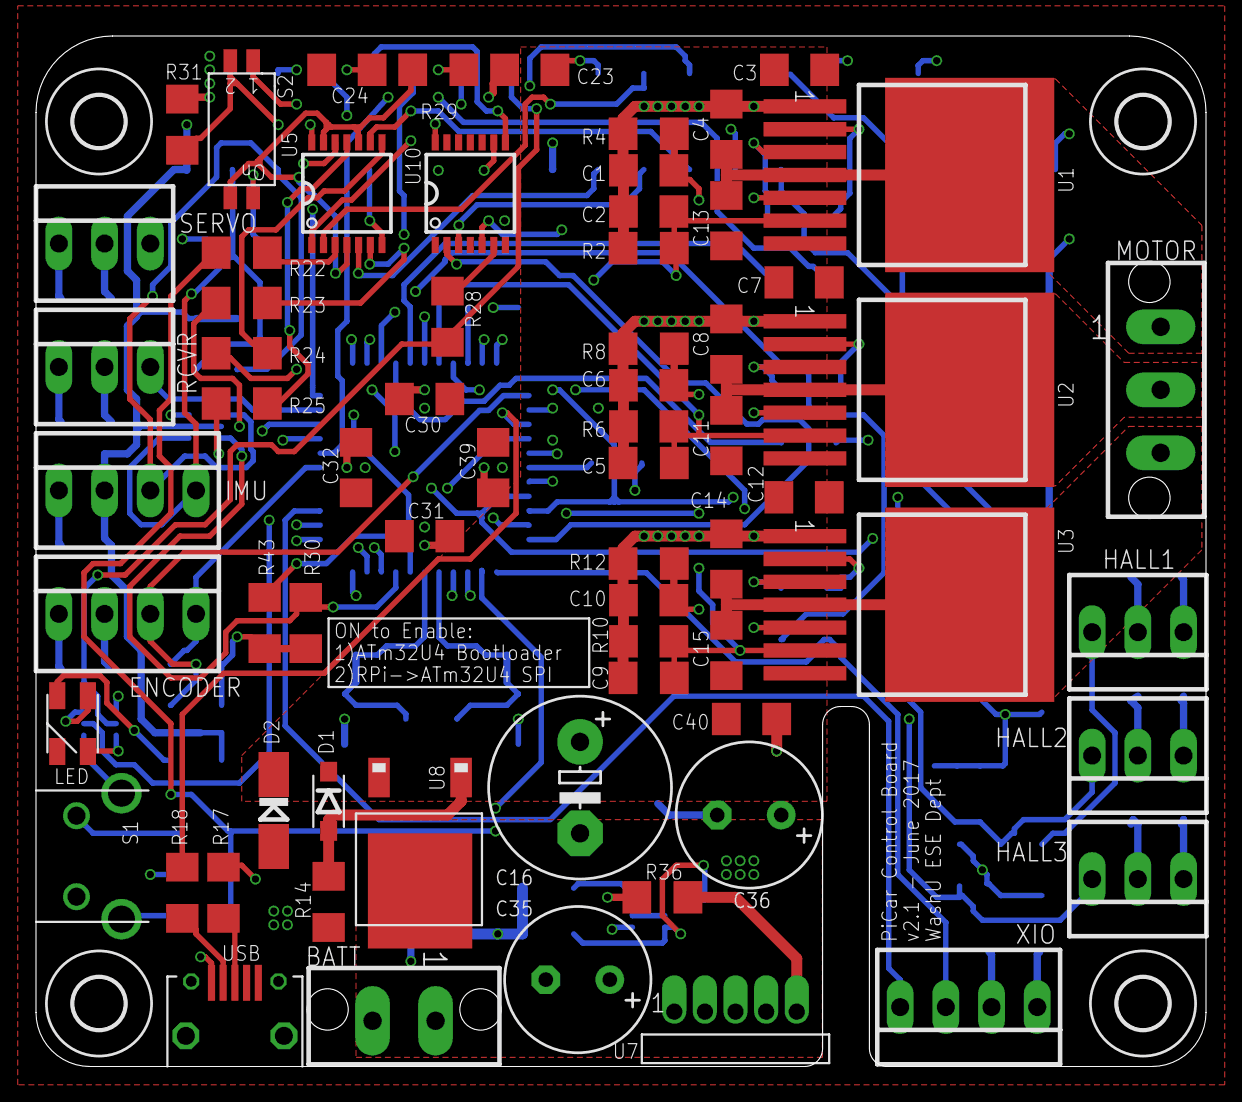
[picture p113: board hw/motorcontrol/v2.1/motorcontrol.brd from above]

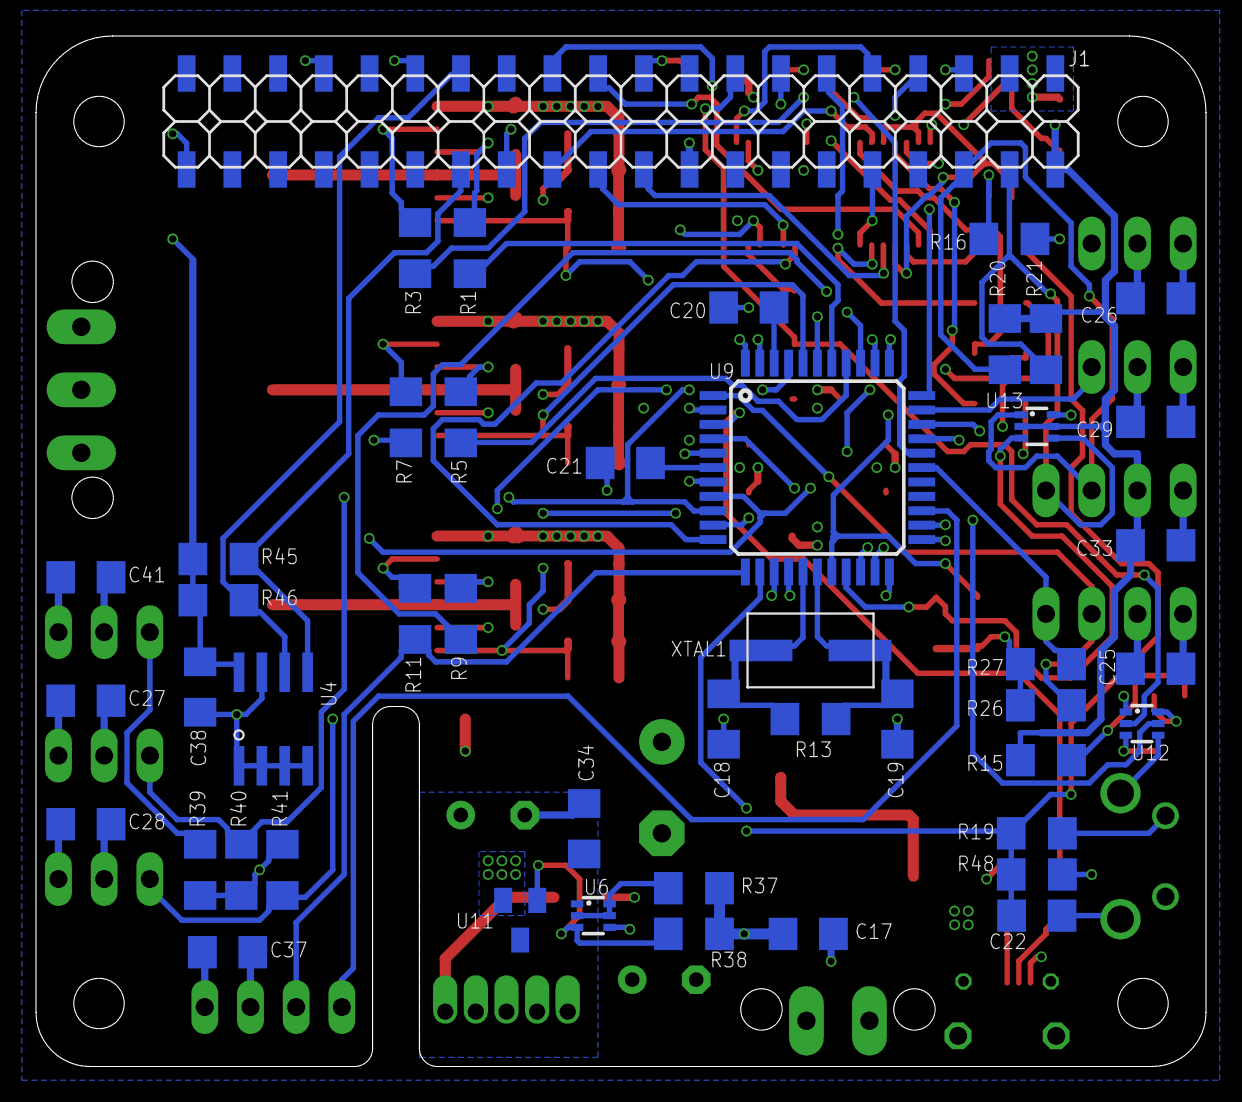
[picture p114: board hw/motorcontrol/v2.1/motorcontrol.brd from below]

Board: 4 copper layers, 65.0 x 57.2 mm, 117 parts (45 on the bottom side), 80 nets.
