xz-group/PiCar/hw/motorcontrol/v2.0/motorcontrol.brd

## EAGLE design hw/motorcontrol/v2.0/motorcontrol.brd (2017-05-25, an earlier design)

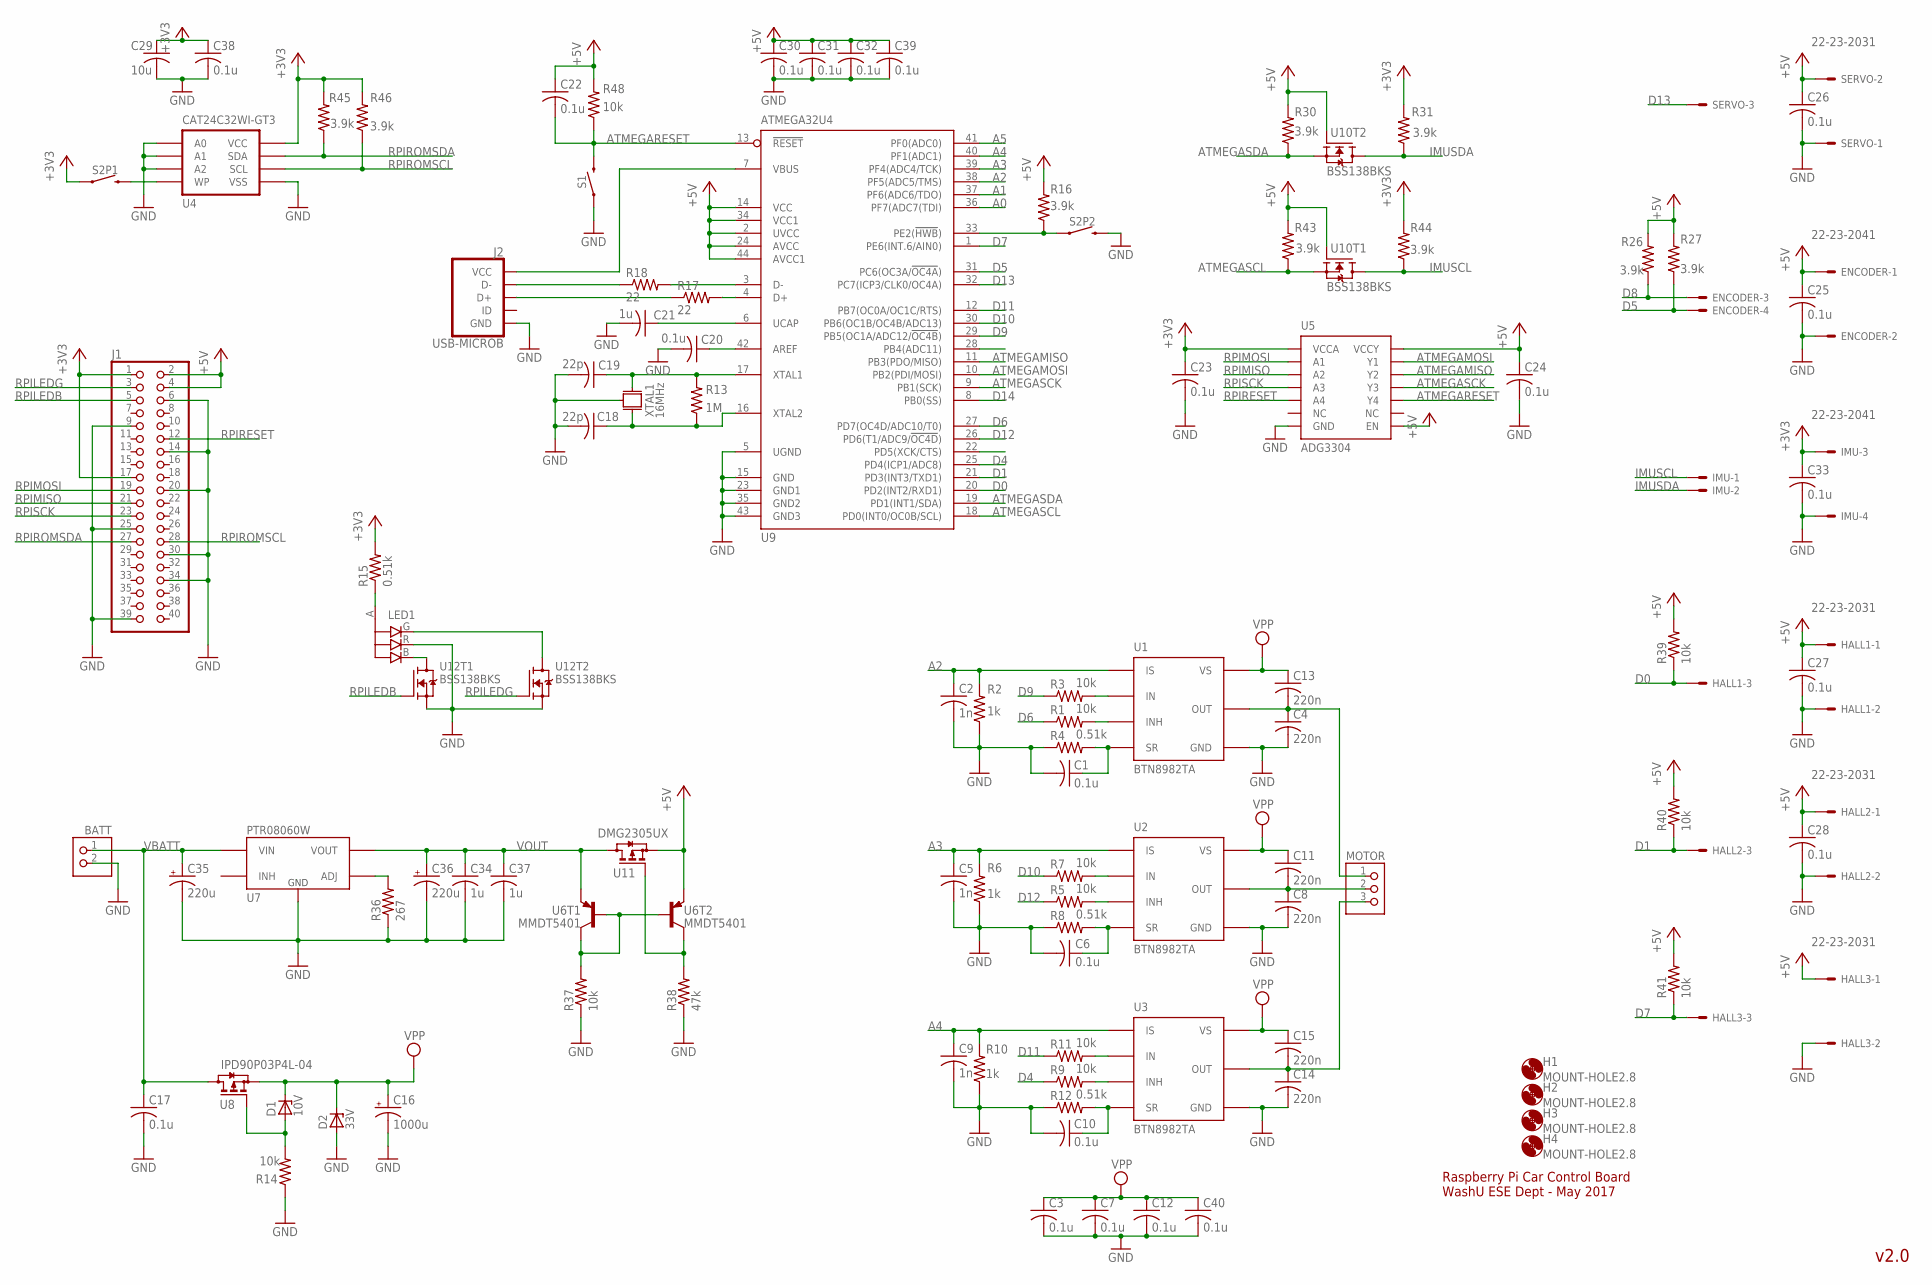
[picture p115: schematic motorcontrol.sch]

Parts:
BATT: ULTRAFIT_2CIRCVCLIP; ULTRAFIT_2CIRC_VERTCLIP
C1, C3, C6, C7, C10, C12, C17, C20, C22, C23, C24, C25, C26, C27, C28, C30, C31, C32, C33, C38, C39, C40: 0.1u; C1206
C2, C5, C9: 1n; C1206
C4, C8, C11, C13, C14, C15: 220n; C1206
C16: 1000u; E5-10,5
C18, C19: 22p; C1206
C21, C34, C37: 1u; C1206
C29: 10u; C1206
C35, C36: 220u; E3,5-8
D1: 10V; SOD80C
D2: 33V; SMA
ENCODER: 22-23-2041
H1, H2, H3, H4: MOUNT-HOLE2.8; 2,8
HALL1, HALL2, HALL3: 22-23-2031
IMU: 22-23-2041
J1: RPIHEADER_2.54-SMD; RPI_SMD
J2: USB-MICROB; FCI-10103594-0001LF
LED1: MSL0201RGB
MOTOR: ULTRAFIT_3CIRCVCLIP; ULTRAFIT_3CIRC_VERTCLIP
R1, R3, R5, R7, R9, R11, R14, R37, R39, R40, R41, R48: 10k; R1206
R2, R6, R10: 1k; R1206
R4, R8, R12, R15: 0.51k; R1206
R13: 1M; R1206
R16, R26, R27, R30, R31, R43, R44, R45, R46: 3.9k; R1206
R17, R18: 22; R1206
R36: 267; R1206
R38: 47k; R1206
S1: B3U-3000P-B
S2: A6HF-2DIP; A6HF
SERVO: 22-23-2031
U1, U2, U3: BTN8982TA; TO263-7
U4: CAT24C32WI-GT3; SOIC8
U5: ADG3304; TSSOP14
U6: MMDT5401; SOT363
U7: PTR08060W; EDP_MODULE
U8: IPD90P03P4L-04; TO252-3-11
U9: ATMEGA32U4; TQFP44
U10, U12: BSS138BKS; SOT363
U11: DMG2305UX; SOT23-3
XTAL1: 16MHz; ABM3B

Connections:
+3V3: C23.1, C29.1, C33.1, C38.1, IMU.3, J1.1, J1.17, R15.2, R31.2, R44.2, R45.2, R46.2, S2.P1.1 (1), U4.8 (VCC), U5.1 (VCCA)
+5V: C22.1, C24.1, C25.1, C26.1, C27.1, C28.1, C30.1, C31.1, C32.1, C39.1, ENCODER.1, HALL1.1, HALL2.1, HALL3.1, J1.2, J1.4, R16.2, R26.2, R27.2, R30.2, R39.2, R40.2, R41.2, R43.2, R48.2, SERVO.2, U5.8 (EN), U5.14 (VCCY), U6.4 (E), U9.2 (UVCC), U9.14 (VCC), U9.24 (AVCC), U9.34 (VCC1), U9.44 (AVCC1), U10.2 (G), U10.5 (G), U11.2 (S)
A0: U9.36 (PF7(ADC7(TDI))
A1: U9.37 (PF6(ADC6/TDO))
A2: C2.1, R2.2, U1.6 (IS), U9.38 (PF5(ADC5/TMS))
A3: C5.1, R6.2, U2.6 (IS), U9.39 (PF4(ADC4/TCK))
A4: C9.1, R10.2, U3.6 (IS), U9.40 (PF1(ADC1))
A5: U9.41 (PF0(ADC0))
ATMEGAMISO: U5.12 (Y2), U9.11 (PB3(PDO/MISO))
ATMEGAMOSI: U5.13 (Y1), U9.10 (PB2(PDI/MOSI))
ATMEGARESET: C22.2, R48.1, S1.2, U5.10 (Y4), U9.13 (!RESET!)
ATMEGASCK: U5.11 (Y3), U9.9 (PB1(SCK))
ATMEGASCL: R43.1, U9.18 (PD0(INT0/OC0B/SCL)), U10.1 (S)
ATMEGASDA: R30.1, U9.19 (PD1(INT1/SDA)), U10.4 (S)
D0: HALL1.3, R39.1, U9.20 (PD2(INT2/RXD1))
D1: HALL2.3, R40.1, U9.21 (PD3(INT3/TXD1))
D4: R9.1, U9.25 (PD4(ICP1/ADC8))
D5: ENCODER.4, R27.1, U9.31 (PC6(OC3A/!OC4A!))
D6: R1.1, U9.27 (PD7(OC4D/ADC10/T0))
D7: HALL3.3, R41.1, U9.1 (PE6(INT.6/AIN0))
D8: ENCODER.3, R26.1, U9.28 (PB4(ADC11))
D9: R3.1, U9.29 (PB5(OC1A/ADC12/!OC4B!))
D10: R7.1, U9.30 (PB6(OC1B/OC4B/ADC13))
D11: R11.1, U9.12 (PB7(OC0A/OC1C/RTS))
D12: R5.1, U9.26 (PD6(T1/ADC9/!OC4D!))
D13: SERVO.3, U9.32 (PC7(ICP3/CLK0/OC4A))
D14: U9.8 (PB0(SS))
GND: BATT.2, C1.2, C2.2, C3.2, C4.2, C5.2, C6.2, C7.2, C8.2, C9.2, C10.2, C12.2, C14.2, C16.-, C17.2, C18.2, C19.2, C20.2, C21.2, C23.2, C24.2, C25.2, C26.2, C27.2, C28.2, C29.2, C30.2, C31.2, C32.2, C33.2, C34.2, C35.-, C36.-, C37.2, C38.2, C39.2, C40.2, D2.A, ENCODER.2, HALL1.2, HALL2.2, HALL3.2, IMU.4, J1.6, J1.9, J1.14, J1.20, J1.25, J1.30, J1.34, J1.39, J2.5 (GND), J2.GND1 (GND), J2.GND2 (GND), LED1.R, R2.1, R4.1, R6.1, R8.1, R10.1, R12.1, R14.1, R36.1, R37.1, R38.1, S1.1, S2.P2.2 (2), SERVO.1, U1.1 (GND), U2.1 (GND), U3.1 (GND), U4.1 (A0), U4.2 (A1), U4.3 (A2), U4.4 (VSS), U5.7 (GND), U7.P3 (GND), U9.5 (UGND), U9.15 (GND), U9.23 (GND1), U9.35 (GND2), U9.43 (GND3), U12.1 (S), U12.4 (S), XTAL1.GND2 (2), XTAL1.GND4 (2)
IMUSCL: IMU.1, R44.1, U10.6 (D)
IMUSDA: IMU.2, R31.1, U10.3 (D)
unnamed: R1.2, U1.3 (INH)
unnamed: R38.2, U6.3 (C), U11.1 (G)
unnamed: C18.1, R13.1, U9.16 (XTAL2), XTAL1.P3 (3)
unnamed: R3.2, U1.2 (IN)
unnamed: C1.1, R4.2, U1.5 (SR)
unnamed: R5.2, U2.3 (INH)
unnamed: C19.1, R13.2, U9.17 (XTAL1), XTAL1.P1 (1)
unnamed: R16.1, S2.P2.1 (1), U9.33 (PE2(!HWB!))
unnamed: R7.2, U2.2 (IN)
unnamed: LED1.A, R15.1
unnamed: C6.1, R8.2, U2.5 (SR)
unnamed: S2.P1.2 (2), U4.7 (WP)
unnamed: R37.2, U6.2 (B), U6.5 (B), U6.6 (C)
unnamed: LED1.B, U12.6 (D)
unnamed: R9.2, U3.3 (INH)
unnamed: J2.2 (D-), R18.1
unnamed: R11.2, U3.2 (IN)
unnamed: C10.1, R12.2, U3.5 (SR)
unnamed: C20.1, U9.42 (AREF)
unnamed: C21.1, U9.6 (UCAP)
unnamed: D1.A, R14.2, U8.1 (G)
unnamed: LED1.G, U12.3 (D)
unnamed: R18.2, U9.3 (D-)
unnamed: R17.2, U9.4 (D+)
unnamed: J2.3 (D+), R17.1
unnamed: R36.2, U7.P5 (ADJ)
OUT1: C4.1, C13.2, MOTOR.1, U1.4 (OUT), U1.8 (OUT)
OUT2: C8.1, C11.2, MOTOR.2, U2.4 (OUT), U2.8 (OUT)
OUT3: C14.1, C15.2, MOTOR.3, U3.4 (OUT), U3.8 (OUT)
RPILEDB: J1.5, U12.2 (G)
RPILEDG: J1.3, U12.5 (G)
RPIMISO: J1.21, U5.3 (A2)
RPIMOSI: J1.19, U5.2 (A1)
RPIRESET: J1.12, U5.5 (A4)
RPIROMSCL: J1.28, R46.1, U4.6 (SCL)
RPIROMSDA: J1.27, R45.1, U4.5 (SDA)
RPISCK: J1.23, U5.4 (A3)
VBATT: BATT.1, C17.1, C35.+, U7.P2 (VIN), U8.2 (D)
VBUS: J2.1 (VCC), U9.7 (VBUS)
VOUT: C34.1, C36.+, C37.1, U6.1 (E), U7.P4 (VOUT), U11.3 (D)
VPP: C3.1, C7.1, C11.1, C12.1, C13.1, C15.1, C16.+, C40.1, D1.C, D2.C, U1.7 (VS), U2.7 (VS), U3.7 (VS), U8.3 (S)

Notes on the sheet:
Raspberry Pi Car Control Board WashU ESE Dept - May 2017
v2.0

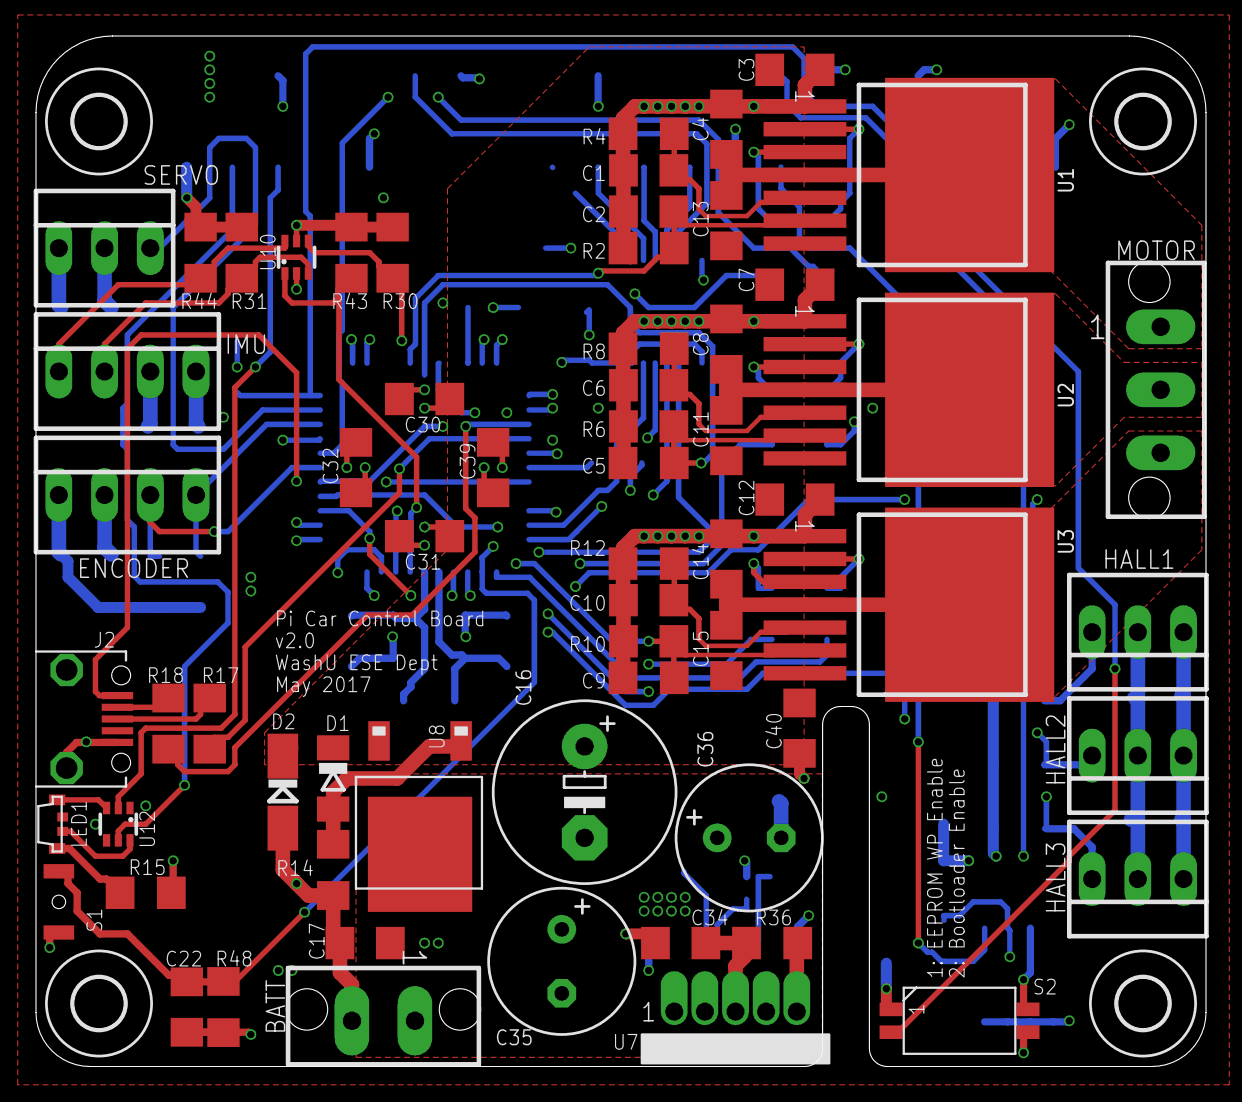
[picture p116: board hw/motorcontrol/v2.0/motorcontrol.brd from above]

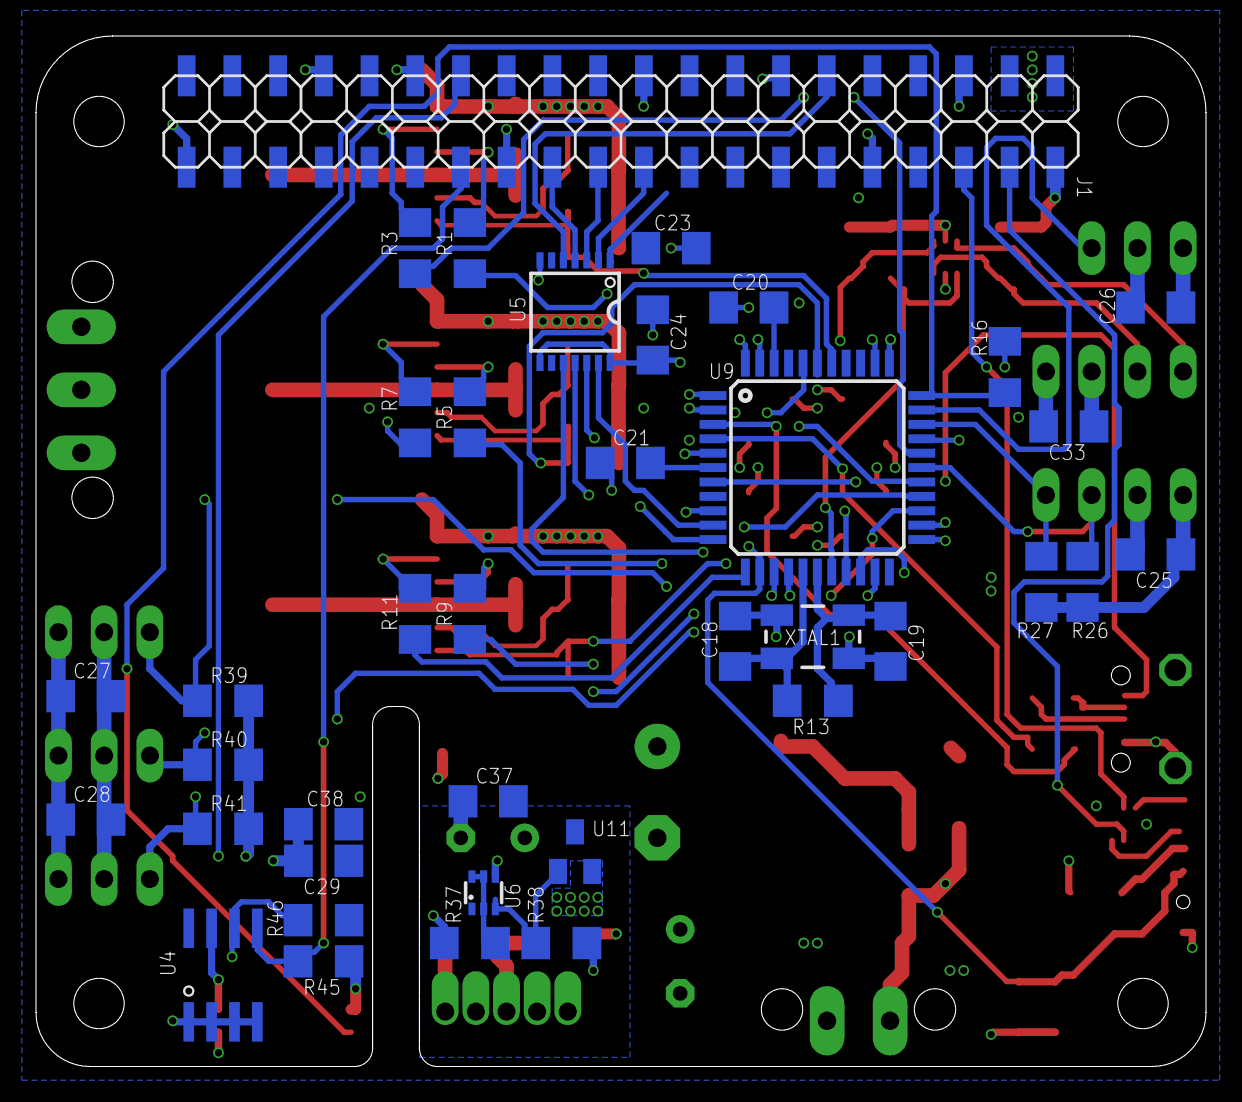
[picture p117: board hw/motorcontrol/v2.0/motorcontrol.brd from below]

Board: 4 copper layers, 65.0 x 57.2 mm, 105 parts (37 on the bottom side), 67 nets.
