xz-group/PiCar/hw/motorcontrol/v1.0/rpibout.brd

## EAGLE design hw/motorcontrol/v1.0/rpibout.brd (2016-11-18, an earlier design)

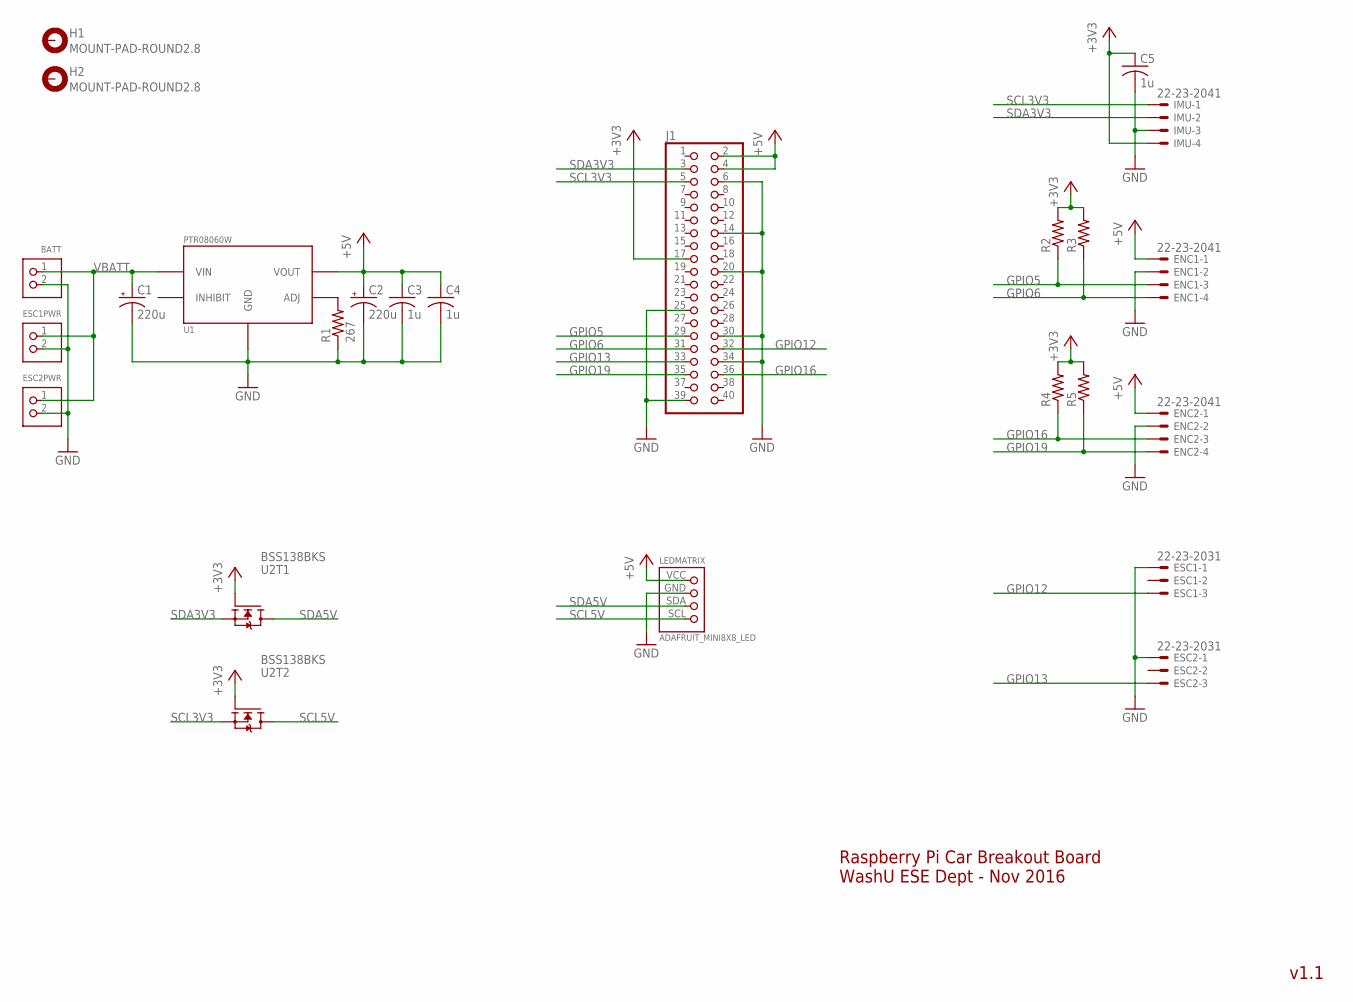
[picture p118: schematic rpibout.sch]

Parts:
BATT: ULTRAFIT_2CIRC; ULTRAFIT_2CIRC_RANGLE
C1, C2: 220u; E3,5-8
C3, C4, C5: 1u; C1206
ENC1, ENC2: 22-23-2041
ESC1, ESC2: 22-23-2031
ESC1PWR, ESC2PWR: ULTRAFIT_2CIRC; ULTRAFIT_2CIRC_RANGLE
H1, H2: MOUNT-PAD-ROUND2.8; 2,8-PAD
IMU: 22-23-2041
J1: PINHD-2X20; 2X20
LEDMATRIX: ADAFRUIT_MINI8X8_LED; ADAFRUIT_MINI8X8_BACKPACK
R1: 267; R1206
R2, R3, R4, R5: R-US_R1206; R1206
U1: PTR08060W; EDP_MODULE
U2: BSS138BKS; SOT363

Connections:
+3V3: C5.1, IMU.4, J1.17, R2.2, R3.2, R4.2, R5.2, U2.2 (G), U2.5 (G)
+5V: C2.+, C3.1, C4.1, ENC1.1, ENC2.1, J1.2, J1.4, LEDMATRIX.VCC, U1.P4 (VOUT)
GND: BATT.2, C1.-, C2.-, C3.2, C4.2, C5.2, ENC1.2, ENC2.2, ESC1.1, ESC1PWR.2, ESC2.1, ESC2PWR.2, IMU.3, J1.6, J1.14, J1.20, J1.25, J1.30, J1.34, J1.39, LEDMATRIX.GND, R1.1, U1.P3 (GND)
GPIO5: ENC1.3, J1.29, R2.1
GPIO6: ENC1.4, J1.31, R3.1
GPIO12: ESC1.3, J1.32
GPIO13: ESC2.3, J1.33
GPIO16: ENC2.3, J1.36, R4.1
GPIO19: ENC2.4, J1.35, R5.1
unnamed: R1.2, U1.P5 (ADJ)
SCL3V3: IMU.1, J1.5, U2.4 (S)
SCL5V: LEDMATRIX.SCL, U2.3 (D)
SDA3V3: IMU.2, J1.3, U2.1 (S)
SDA5V: LEDMATRIX.SDA, U2.6 (D)
VBATT: BATT.1, C1.+, ESC1PWR.1, ESC2PWR.1, U1.P2 (VIN)

Notes on the sheet:
v1.1
Raspberry Pi Car Breakout Board WashU ESE Dept - Nov 2016

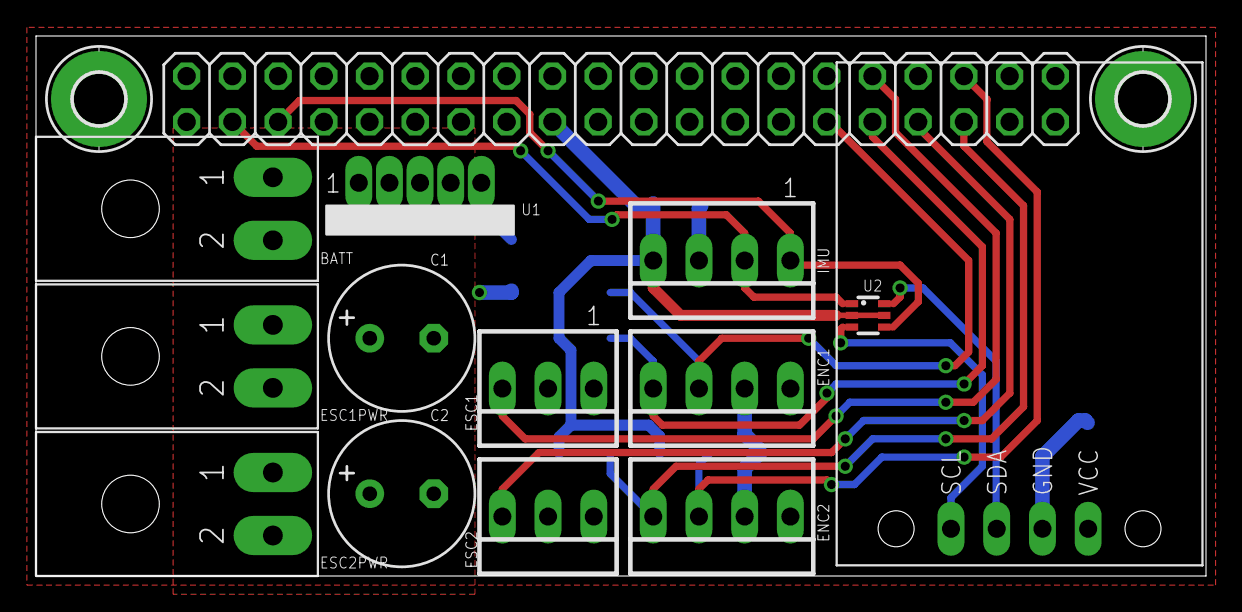
[picture p119: board rpibout.brd from above]

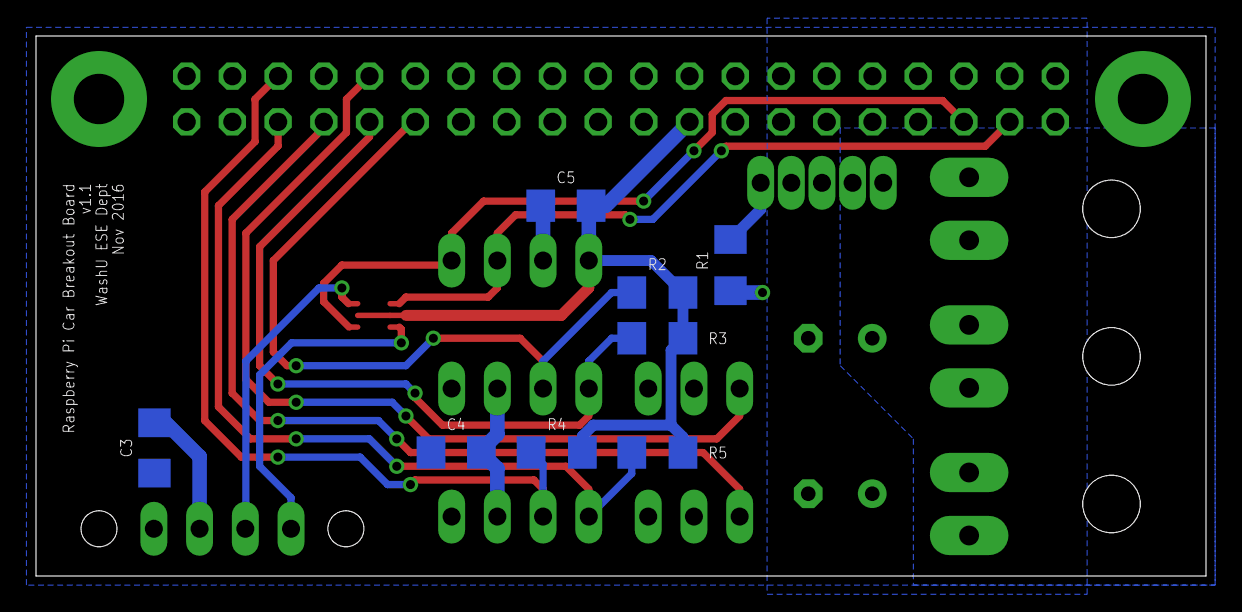
[picture p120: board rpibout.brd from below]

Board: 2 copper layers, 65.0 x 30.0 mm, 24 parts (8 on the bottom side), 15 nets.
