xz-group/PiCar/src/mobile_movement_control/WASD.ino

/*
 * Author: AnZou(anzou@wustl.edu)
 * PID speed control for BLCD
 * BLDC(+ESC): TRACKSTAR
 * Encoder: YUMOE6A2
 * Controller: Arduino UNO R3
*/

/*
 * Pin Definition
 * Pin2 for encoder: interrupt signal
 * Pin13 for BLDC ESC: PPM signal
 * 
*/

#define reference_signal 35 // set the speed in RPS here
#include <Servo.h>
#define K_p 0.1
#define K_i 0
#define K_d 0.001
#include <Wire.h>
#include <SimpleTimer.h>
SimpleTimer timer;
#define SLAVE_ADDRESS 0x04
#define KILL_SWITCH_IN 1 //using interrupt 1 for kill switch
#define KILL_SWITCH_IN_PIN 3 //interrupt 1 = digital pin 3
#define KILL_SWITCH_OUT_PIN 7

unsigned long t = 0;
double encoder_counter;
double motor_speed; //rotations per second
int number = 0;
double control_signal;
double e_k; // variable for P
double e_k1; // variable for I (not in use)
double e_k2; // variable for D (not in use)
Servo myservo;
int servo_angle = 90;
int state = 0;
int times = 0;
int flag = 0;
int right_counter = 0;
int left_counter = 0;
boolean from_left = false;

const int SENSOR_PIN = A0;      // Input pin for measuring Vout
const int RS = 10;              // Shunt resistor value (in ohms)
const int VOLTAGE_REF = 5;      // Reference voltage for analog read
float sensorValue;              // Variable to store value from analog read
float current = 0;              // Variable to store computed current value from analog read
float total = 0, average = 0;   // Variables to store sum of currents and the average current
int count = 0, start = 0;       // Number of calls to analog read
int byteNum = 1;                // Variable to loop through the 4 bytes being sent to RPi 

void setup() {
  // put your setup code here, to run once:
  Serial.begin(9600);
  myservo.attach(9);
  e_k = 0;
  e_k1 = 0;
  e_k2 = 0; 
  control_signal = 150; //PWM

  attachInterrupt(KILL_SWITCH_IN, kill, RISING); //for kill switch
  pinMode(KILL_SWITCH_OUT_PIN, OUTPUT);
  digitalWrite(KILL_SWITCH_OUT_PIN, HIGH);
  Serial.println("Start!");
  pinMode(13, OUTPUT);
  delay(3000);

  Serial.println("Calibrating ESC for positive RPM");
  calibration(500); // Calibrating ESC for +ve RPM
  Serial.println("Calibrating ESC for negative RPM");
  calibration(-500); // Calibrating ESC for -ve RPM
  Serial.println("Calibrating ESC for zero RPM");
  calibration(0); // Calibrating ESC for 0 RPM

  // initialize i2c as slave
  Wire.begin(SLAVE_ADDRESS);

  // define callbacks for i2c communication
  Wire.onReceive(receive_data);
  Wire.onRequest(send_data);
  Serial.println("Ready!");
  
  // timed actions setup
  timer.setInterval(350, current_sensor);
}

void loop() {
  timer.run();
  
  switch(number){
    case 1 :
      if(from_left == true){
        from_left = false;
        myservo.write(75);
        delay(100);
      }
      myservo.write(95);
      control_signal = control_signal + increment_pid();
      PPM_output(control_signal);
      break;
    case 2 :
      myservo.write(95);
      PPM_output(-150);
      break;
    case 3 :
      if (right_counter == 1) {
        myservo.write(75);
        control_signal = control_signal + increment_pid();
        PPM_output(control_signal);
      }
      else if (right_counter == 2) {
        myservo.write(65);
        control_signal = control_signal + increment_pid();
        PPM_output(control_signal);
      }
      else if (right_counter == 3) {
        myservo.write(55);
        control_signal = control_signal + increment_pid();
        PPM_output(control_signal);
      }
      break;
    case 4 :
      from_left = true;
      if (left_counter == 1) {
        myservo.write(105);
        control_signal = control_signal + increment_pid();
        PPM_output(control_signal);
      }
      else if (left_counter == 2) {
        myservo.write(115);
        control_signal = control_signal + increment_pid();
        PPM_output(control_signal);
      }
      else if (left_counter == 3) {
        myservo.write(125);
        control_signal = control_signal + increment_pid();
        PPM_output(control_signal);
      }
      break;
    default :
      PPM_output(0); 
  }
  
//  if (flag == 1){
//    unsigned long currentMillis = millis();
//    myservo.write(servo_angle);
//    if(currentMillis - t > number*1000) {
//      Serial.println("Finished");
//      PPM_output(0);
//    }
//  
//    else {
//      control_signal = control_signal + increment_pid();
//      PPM_output(control_signal);
//      Serial.println("Running: ");
//    }
//  }
}  

void speed_measure() {
  // measures the motor rpm using quadrature encoder
  encoder_counter = 0;
  attachInterrupt(0, encoder, RISING);
  delay(50); // Wait for 50 ms  
  detachInterrupt(0);
  motor_speed =  encoder_counter * 20 / 200;
}

void encoder()  
{  
  // increments the encoder count when a rising edge
  // is detected by the interrupts 
  encoder_counter = encoder_counter + 1;
}

double increment_pid()
{
  double increment;
  speed_measure();
  e_k2 = e_k1;
  e_k1 = e_k;
  e_k = reference_signal - motor_speed;
  
  if((e_k>5)||(e_k<-5))
  {
    increment = K_p*e_k;
  }
  else
  {
    increment = 0;  
  }
  
  //increment boundary/saturation
  if(increment > 1)
  {
   increment = 1; 
  }
  
  if(increment < -1)
  {
   increment = -1; 
  }
  
  return increment;
}

void calibration(int command)
{
  int i = 400;  
  while(i>1)
  {
    int rate = 1500 + command;
    digitalWrite(13, HIGH);
    delayMicroseconds(rate);
    digitalWrite(13, LOW);
    delayMicroseconds(10000);
    delayMicroseconds(10000 - rate);
    i = i-1;
  }  
}

void PPM_output(int command) {
  int rate = 1500 + command;
  digitalWrite(13, HIGH);
  delayMicroseconds(rate);
  digitalWrite(13, LOW);
  delayMicroseconds(10000);
  delayMicroseconds(10000 - rate);
}

void receive_data(int byteCount){
  while(Wire.available()) {
    number = Wire.read();
    //Serial.println(number);
    if (number != 3){
      right_counter = 0;
    }
    if (number != 4){
      left_counter = 0;
    }
    if (number == 3){
      if (right_counter != 3){ 
        right_counter++;
      }
    }
    else if (number == 4){
      if (left_counter != 3){
        left_counter++;
      }
    }
  }
}
// callback for sending data
void send_data(){
  Wire.write(number);
}

void kill(){
  digitalWrite(KILL_SWITCH_OUT_PIN, LOW);
}

/*
 * Reads the analog voltage value which is mapped between 0 and 1023
 * Converts the voltage value to the current value using Ohm's Law
 * Calls the functions to computer current average and send the data to RPi
 */
void current_sensor(){
    Serial.println();
    Serial.println("current sensing now");
    sensorValue = analogRead(SENSOR_PIN);
    sensorValue = (sensorValue * VOLTAGE_REF) / 1023;
    current = sensorValue / (10 * RS);
    avg(current);
   switch(number){
    case 1 :
      if(from_left == true){
        from_left = false;
        myservo.write(75);
        delay(100);
      }
      myservo.write(95);
      control_signal = control_signal + increment_pid();
      PPM_output(control_signal);
      break;
    case 2 :
      myservo.write(95);
      PPM_output(-150);
      break;
    case 3 :
      if (right_counter == 1) {
        myservo.write(75);
        control_signal = control_signal + increment_pid();
        PPM_output(control_signal);
      }
      else if (right_counter == 2) {
        myservo.write(65);
        control_signal = control_signal + increment_pid();
        PPM_output(control_signal);
      }
      else if (right_counter == 3) {
        myservo.write(55);
        control_signal = control_signal + increment_pid();
        PPM_output(control_signal);
      }
      break;
    case 4 :
      from_left = true;
      if (left_counter == 1) {
        myservo.write(105);
        control_signal = control_signal + increment_pid();
        PPM_output(control_signal);
      }
      else if (left_counter == 2) {
        myservo.write(115);
        control_signal = control_signal + increment_pid();
        PPM_output(control_signal);
      }
      else if (left_counter == 3) {
        myservo.write(125);
        control_signal = control_signal + increment_pid();
        PPM_output(control_signal);
      }
      break;
    default :
      PPM_output(0); 
  }
}

/*
 * Computes the average value of all current readings
 * Prints the computation to the serial monitor
 */
void avg(float current){
    total += current;
    count++;
    average = total / count;
    Serial.print("The average of the readings is ");
    Serial.print(current, 9);
    Serial.print("A");
    Serial.println();        
}
