xz-group/PiCar/src/arduino_PCB/servocontrol.c

//
//  servocontrol.c
//
//
//  Created by Matt Kollada on 5/17/17.
//
//

#include "servocontrol.h"

//Servo servo;

void attachServoToPin() {
//  servo.attach( SERVO_PIN );
}

void setServoAngle(int16_t angle) {
  if( angle > 0 & angle < 180) {
//    servo.write(angle);
  }
}
