xz-group/PiCar/src/pi_arduino_comm/spi/spiProtocol/spiProtocol.ino

/*
Author: Feiyang Jin
Email: feiyang.jin@wustl.edu
Organization: Washington University in St. Louis
Date: July 2018
*/
#include <SPI.h>

byte inputByte = 100;

int beginSendingFloat = 0;
int currentSendFloatByte = 1;
float data = 2.34567;

int beginReadingFloat = 0;
int currentReadFloatByte = 1;

typedef union{
byte asBytes[4];
float asFloat;
} floatval;

floatval v;


int intData = 0;
int beginReadingInt = 0;

void setup (void)
{
  Serial.begin(9600);
  pinMode(MISO, OUTPUT);
  SPCR |= _BV(SPE);

}

void loop (void)
{
  //if there is something to read
  if((SPSR & (1 << SPIF)) != 0)
  {
    inputByte = SPDR;
    //Serial.print("we received: ");
    //Serial.println(c);

    //we first decide we are in the process or reading data
    //if not, we explain the byte as data header:
    //if we receive 2, we know pi wants to read a float
    //if we receive 3, we know pi wants to send a float
    //if we receive 4, we know pi wants to send a int
    if(beginReadingInt){
      readInt();
    }
    else if(beginReadingFloat){
      readFloatByByte();
    }
    else if(inputByte == 0 && beginSendingFloat){
      sendFloatByByte();
    }
    else if(inputByte == 2){
      SPDR = 35;
      beginSendingFloat = 1;
    }
    else if(inputByte == 3){
      SPDR = 36;
      beginReadingFloat = 1;
    }
    else if(inputByte == 4 && !beginReadingInt){
      beginReadingInt = 1;
    }

  }

}


void readInt(){
  intData = inputByte;
  Serial.print("the int we received is:");
  Serial.println(intData);
  beginReadingInt = 0;
}

void readFloatByByte(){
  switch(currentReadFloatByte){
    case 1:
      v.asBytes[0] = inputByte;
      currentReadFloatByte++;
      break;

    case 2:
      v.asBytes[1] = inputByte;
      currentReadFloatByte ++;
      break;

    case 3:
      v.asBytes[2] = inputByte;
      currentReadFloatByte ++;
      break;

    case 4:
      v.asBytes[3] = inputByte;
      currentReadFloatByte = 1;
      beginReadingFloat = 0;
      Serial.print("The float we received is:");
      Serial.println(v.asFloat,5);
      break;

  }
}

void sendFloatByByte(){
  volatile unsigned long rawBits;
      rawBits =  *(unsigned long *) &data;
      switch(currentSendFloatByte){
        case 1:
        SPDR = (rawBits >> 24 & 0xff);
        currentSendFloatByte ++;
        break;

        case 2:
        SPDR = (rawBits >> 16 & 0xff);
        currentSendFloatByte ++;
        break;

        case 3:
        SPDR = (rawBits >> 8 & 0xff);
        currentSendFloatByte ++;
        break;

        case 4:
        SPDR = (rawBits & 0xff);
        currentSendFloatByte = 1;
        beginSendingFloat = 0;
        break;

      }
}
