xz-group/PiCar/src/pi/computer_vision/TrackingAndDetection/src/trackingPlatform/ReportGenerator.py

import matplotlib.pyplot as plt
from sklearn.metrics import mean_squared_error, mean_absolute_error
import numpy as np
from math import sqrt
import os
import csv
'''
ReportGenerator
    INPUT:
        - path to true data
        - path to calculated data

    OUTPUT:
        - plots
        - Results.txt with error results and header

    TO-DO
    1. Generate plots
    2. Calculate errors
    3. Output plots and errors to a project report folder

'''
def getDist(pt1,pt2):
    x1,y1 = pt1
    x2,y2 = pt2
    return sqrt((x2-x1)*(x2-x1) + (y2-y1)*(y2-y1))

def ensure_dir(directory):
    if not os.path.exists(directory):
        os.makedirs(directory)
    return directory

class ReportGenerator(object):
    def __init__(self,videoPath,truePath,testPath,timingPath,keypointFinder,featureMatcher,failureDetector):
        self.truePath = truePath
        self.testPath = testPath
        self.timingPath = timingPath
        self.videoPath = videoPath.split('.')[0]
        self.trueData = []
        self.testData = []
        self.timingData = []
        self.keypointFinder = keypointFinder
        self.featureMatcher = featureMatcher
        self.reportPath = ensure_dir("reports/" + self.videoPath + "_" + self.keypointFinder + "_" + self.featureMatcher)
        self.failureDetector = failureDetector


    def calculateErrors(self):
        # Generate and write to results in resultsFile
        true = []
        test = []
        timing = []

        # Read true data
        with open(self.truePath,'r') as csvfile:
            readCSV = csv.reader(csvfile, delimiter=',')
            for x,y in readCSV:
                x = int(x)
                y = int(y)
                true.append([x,y])

        # Read test data
        with open(self.testPath,'r') as csvfile:
            readCSV = csv.reader(csvfile, delimiter=',')
            for x,y in readCSV:
                x = float(x)
                y = float(y)
                test.append([x,y])

        # Trim first data points to have equal sized
        self.trueData = true[2:]
        self.testData = test[:len(self.trueData)]
        self.trueData = self.trueData[:len(self.testData)]

        dist = []
        y_actual = [0 for i in range(len(self.trueData))]

        # Calculate Euclidian Distance between points
        for i in range(len(self.trueData)):
            # print(self.testData[i])
            dist.append(getDist(self.trueData[i],self.testData[i]))

        rms = (sqrt(mean_squared_error(y_actual, dist)))
        mea = mean_absolute_error(y_actual,dist)

        rmsArray = []
        maeArray = []
        for i in range(1,len(dist)):
            actual = [0 for x in range(i)]
            calculated = dist[:i]
            rmsArray.append(sqrt(mean_squared_error(actual, calculated)))
            maeArray.append(mean_absolute_error(actual, calculated))

        sampling = []
        matching = []
        tracking = []
        frames = []
        fpsArray = []
        numPts = []

        frameNumber = 1
        with open(self.timingPath,'r') as csvfile:
            readCSV = csv.reader(csvfile, delimiter=',')
            for sample,match,track,fpsTime,pts in readCSV:

                sampling.append(float(sample))
                matching.append(float(match))
                tracking.append(float(track))
                fpsArray.append(float(fpsTime))
                numPts.append(int(pts))
                frames.append(frameNumber)
                frameNumber += 1


        plt.scatter(frames, sampling, s=10, c='b', marker="o", label=self.keypointFinder)
        plt.scatter(frames, matching, s=10, c='r', marker="o", label=self.featureMatcher)
        plt.scatter(frames, tracking, s=10, c='g', marker="o", label='tracking')
        plt.xlabel("Frame Number")
        plt.ylabel("Time Taken")
        plt.title("Time taken At Each Step vs Frame Number")
        plt.legend(loc='upper left')
        plt.xlim(xmin=0)
        plt.ylim(ymin=0)
        plt.savefig(self.reportPath+"/timingVsFrame.png")
        plt.clf()

        plt.scatter(frames,fpsArray,s=10,marker='o',label="FPS")
        plt.xlabel("Frame Number")
        plt.ylabel("FPS")
        plt.title("FPS vs Frame Number")
        plt.xlim(xmin=0)
        plt.ylim(ymin=0,ymax=250)
        plt.savefig(self.reportPath+"/fpsVsFrame.png")
        plt.clf()

        plt.scatter(numPts,fpsArray,s=10,marker='o',label="FPS")
        plt.xlabel("Number of Tracked Points")
        plt.ylabel("FPS")
        plt.title("FPS vs Number of Tracked Points")
        plt.xlim(xmin=0)
        plt.ylim(ymin=0,ymax=250)
        plt.savefig(self.reportPath+"/fpsVsNumPts.png")
        plt.clf()

        plt.scatter(numPts[:len(rmsArray)],rmsArray,s=10,c='b',marker='o',label="RMS")
        plt.scatter(numPts[:len(maeArray)],maeArray,s=10,c='r',marker='o',label="MAE")
        plt.xlabel("Number of Tracked Points")
        plt.ylabel("Error Value")
        plt.legend(loc='upper left')
        plt.title("RMS/MAE vs Number of Tracked Points")
        plt.xlim(xmin=0)
        plt.ylim(ymin=0)
        plt.savefig(self.reportPath+"/errVsNumPts.png")
        plt.clf()


        resultsString = "RESULTS\n\n"
        resultsString += "INFORMATION:\n"
        resultsString += "=================================================\n"
        resultsString += "Video Source: "+ self.videoPath + ".mp4" + "\n"
        resultsString += "Keypoint Finding Method: " + self.keypointFinder + "\n"
        resultsString += "Feature Matching Method: " + self.featureMatcher + "\n\n"
        resultsString += "PERFORMANCE:\n"
        resultsString += "=================================================\n"
        resultsString += "Average FPS: " + str(round(np.mean(fpsArray))) + "\n"
        resultsString += "Average Number of Points Tracked: " + str(round(np.mean(numPts))) + "\n"
        resultsString += "Tracking Failure Occured: " + str(self.failureDetector) + "\n"
        resultsString += "Root mean square Error: " + str(round(rms,3)) + " \n"
        resultsString += "Mean Absolute Error: " + str(round(mea,3)) + " \n"

        resultsFile = open(self.reportPath + "/results.txt", "w")
        resultsFile.write(resultsString)
        resultsFile.close()
        print("[INFO] Results written to " + self.reportPath + "/")


    # def generateReport(self):
    #     # generatePlots()
    #     print("GENERATING REPORT")
    #     calculateErrors()
