xz-group/PiCar/src/arduino_PCB/spi_comm.h

//
//  spi.h
//  
//
//  Created by Matt Kollada on 5/20/17.
//
//

#ifndef spi_h
#define spi_h

#include <stdio.h>

#ifdef __cplusplus
extern "C" {
#endif

void spiHandler();
void executeCommand();

#ifdef __cplusplus
}
#endif

#endif /* spi_h */
