xz-group/PiCar/src/pi/IMU_Lidar/IMU_SETUP.py

#IMU import and setup part
from ctypes import *
path = "LSM9DS1_RaspberryPi_Library/lib/liblsm9ds1cwrapper.so"
lib = cdll.LoadLibrary(path)

lib.lsm9ds1_create.argtypes = []
lib.lsm9ds1_create.restype = c_void_p

lib.lsm9ds1_begin.argtypes = [c_void_p]
lib.lsm9ds1_begin.restype = None

lib.lsm9ds1_calibrate.argtypes = [c_void_p]
lib.lsm9ds1_calibrate.restype = None

lib.lsm9ds1_gyroAvailable.argtypes = [c_void_p]
lib.lsm9ds1_gyroAvailable.restype = c_int
lib.lsm9ds1_accelAvailable.argtypes = [c_void_p]
lib.lsm9ds1_accelAvailable.restype = c_int
lib.lsm9ds1_magAvailable.argtypes = [c_void_p]
lib.lsm9ds1_magAvailable.restype = c_int

lib.lsm9ds1_readGyro.argtypes = [c_void_p]
lib.lsm9ds1_readGyro.restype = c_int
lib.lsm9ds1_readAccel.argtypes = [c_void_p]
lib.lsm9ds1_readAccel.restype = c_int
lib.lsm9ds1_readMag.argtypes = [c_void_p]
lib.lsm9ds1_readMag.restype = c_int

lib.lsm9ds1_getGyroX.argtypes = [c_void_p]
lib.lsm9ds1_getGyroX.restype = c_float
lib.lsm9ds1_getGyroY.argtypes = [c_void_p]
lib.lsm9ds1_getGyroY.restype = c_float
lib.lsm9ds1_getGyroZ.argtypes = [c_void_p]
lib.lsm9ds1_getGyroZ.restype = c_float

lib.lsm9ds1_getAccelX.argtypes = [c_void_p]
lib.lsm9ds1_getAccelX.restype = c_float
lib.lsm9ds1_getAccelY.argtypes = [c_void_p]
lib.lsm9ds1_getAccelY.restype = c_float
lib.lsm9ds1_getAccelZ.argtypes = [c_void_p]
lib.lsm9ds1_getAccelZ.restype = c_float

lib.lsm9ds1_getMagX.argtypes = [c_void_p]
lib.lsm9ds1_getMagX.restype = c_float
lib.lsm9ds1_getMagY.argtypes = [c_void_p]
lib.lsm9ds1_getMagY.restype = c_float
lib.lsm9ds1_getMagZ.argtypes = [c_void_p]
lib.lsm9ds1_getMagZ.restype = c_float

lib.lsm9ds1_calcGyro.argtypes = [c_void_p, c_float]
lib.lsm9ds1_calcGyro.restype = c_float
lib.lsm9ds1_calcAccel.argtypes = [c_void_p, c_float]
lib.lsm9ds1_calcAccel.restype = c_float
lib.lsm9ds1_calcMag.argtypes = [c_void_p, c_float]
lib.lsm9ds1_calcMag.restype = c_float

lib.lsm9ds1_setAccelScale.argtypes = [c_void_p, c_uint]
lib.lsm9ds1_setAccelScale.restype = None
lib.lsm9ds1_setAccelODR.argtypes = [c_void_p, c_uint]
lib.lsm9ds1_setAccelODR.restype = None
lib.lsm9ds1_setGyroScale.argtypes = [c_void_p, c_uint]
lib.lsm9ds1_setGyroScale.restype = None
lib.lsm9ds1_setGyroODR.argtypes = [c_void_p, c_uint]
lib.lsm9ds1_setGyroODR.restype = None
lib.lsm9ds1_setMagScale.argtypes = [c_void_p, c_uint]
lib.lsm9ds1_setMagScale.restype = None
lib.lsm9ds1_setMagODR.argtypes = [c_void_p, c_uint]
lib.lsm9ds1_setMagODR.restype = None
