xz-group/PiCar/(commit log)

2016-11-18 added breakout PCB EAGLE files and datasheets of the components in the board
    [rpibout.brd, rpibout.sch]
2016-11-19 added breakout board BOM
    [BOM.csv]
2016-11-27 Added IMU Datasheet
2016-12-01 Create imu modes
2016-12-11 added Motive client materials
    Former-commit-id: c14022a30cce24f6901098dcd9e65150b9cdedc0
2016-12-11 added Motive client materials
2016-12-12 adding more information to current IMU files
    Former-commit-id: eea27aea0cca901a0b73d22e3e10f0ddd5f641c1
2016-12-12 adding more information to current IMU files
2016-12-12 Update MotorEncoderTest
    Former-commit-id: d9ec2b5fe0d0622b126d8b037bed1070942361a9
2016-12-12 Update MotorEncoderTest
2016-12-12 Add files via upload
    Former-commit-id: 7e4c89ce79c95f37f97226cc54643dc83e004c8f
    [Bottom Motor Holder.step, Camera Post.step, Chassis.step, Encoder Holder.step, Second Level Plate.step, Top Motor Holder.step]
2016-12-12 Add files via upload
    Former-commit-id: 56004bc89d5894f7f4ada79c26f30bf905812212
    [Bottom Motor Holder.stl, Camera Post.stl, Chassis.stl, Encoder Holder.stl, Second Level.stl, Top Motor Holder.stl]
2016-12-12 Delete Top Motor Holder.stl
    Former-commit-id: c78e3a891b90e669fcd4cf582fa35420182f4dca
    [Top Motor Holder.stl]
2016-12-12 Delete Bottom Motor Holder.stl
    Former-commit-id: 7b0c75141266ff4364d445889d535b6cbb3f2d79
    [Bottom Motor Holder.stl]
2016-12-12 Delete Camera Post.stl
    Former-commit-id: 60af92688f3ad7d8b6ca14d55c340c76e0c5c7da
    [Camera Post.stl]
2016-12-12 Delete Chassis.stl
    Former-commit-id: 864117915abe5a9b536842d984d3902a121f1fb3
    [Chassis.stl]
2016-12-12 Delete Encoder Holder.stl
    Former-commit-id: 9ecf17c320218765db0b55f1f673f6b3f027591a
    [Encoder Holder.stl]
2016-12-12 Delete Second Level.stl
    Former-commit-id: fddf176cb9be67161ff288cc1b555bb65338e2cd
    [Second Level.stl]
2016-12-12 Delete Raspberry Pi 3.step
    Former-commit-id: 28903d9e82b4a2a2243642b6d25312ec16d7d854
    [Raspberry Pi 3.step]
2016-12-12 Delete Bottom Motor Holder.step
    Former-commit-id: 0b423e0f47592947cac99a7dcf091beb5a8f9b29
    [Bottom Motor Holder.step]
2016-12-12 Delete Camera Post.step
    Former-commit-id: fe648a3872e05c4a7861ffe97cdd03821cc472a0
    [Camera Post.step]
2016-12-12 Delete Chassis.step
    Former-commit-id: d2bfdbd17d2488d682892fae1333635922468e71
    [Chassis.step]
2016-12-12 Delete Encoder Holder.step
    Former-commit-id: d77f332c4b838db7c23f1b21c4fa436caa77b9b9
    [Encoder Holder.step]
2016-12-12 Delete Second Level Plate.step
    Former-commit-id: c9ab1bda60d73193b3c588a7974dfabf318e3951
    [Second Level Plate.step]
2016-12-12 Delete Top Motor Holder.step
    Former-commit-id: 5b49d73f624811a050614d1b843e7432cf3684cb
    [Top Motor Holder.step]
2016-12-12 Create print_screenshots
    Former-commit-id: 5d96b85f51dd8ad50caf467a5ed0fc6d7f9fba6a
2016-12-12 Create print_screenshots
2016-12-12 Delete print_screenshots
    Former-commit-id: 162a29be139a53220d5c0375e49e3f7134ad63ce
2016-12-14 Added readme file
    Readme has a link to the breakout board wiki.
    Former-commit-id: 889f38c7d9b4f5264c3b8f90ccd0813651547ee1
2016-12-14 Added readme file
    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
2016-12-21 folder reorganization
    Former-commit-id: d99e7f0823bb8640918b9f18b3c3735454fa47ad
    [Bottom Motor Holder.stl, Camera Post.stl, Chassis.stl, Encoder Holder.stl, Second Level.stl, Top Motor Holder.stl]
2016-12-21 folder reorganization
    [Bottom Motor Holder.stl, Camera Post.stl, Chassis.stl, Encoder Holder.stl, Second Level.stl, Top Motor Holder.stl]
2016-12-21 added .step files
    Former-commit-id: d8adeb441c5c6be09399d1d429afeb43d8cf0b97
    [Bottom Motor Holder.step, Bottom Motor Holder.stl, Camera Post.step, Camera Post.stl, Chassis.step, Chassis.stl, Encoder Holder.step, Encoder Holder.stl]
2016-12-21 added .step files
    [Bottom Motor Holder.step, Bottom Motor Holder.stl, Camera Post.step, Camera Post.stl, Chassis.step, Chassis.stl, Encoder Holder.step, Encoder Holder.stl]
2017-03-04 Create raspberry pi hat design
2017-04-05 Add files via upload
    Raspberry Pi to Arduino Shields & Motor Controller
    [pcb.sch]
2017-04-05 pin connection/ components list
    [pcb_parts.xlsx]
2017-04-05 Add files via upload
    pin connections & components list
    [pcb_parts.xlsx]
2017-04-14 minor editorial changes to pcb.sch
    [pcb.sch]
2017-05-01 first commit for Atmel-based motor controller
    [motorcontrol.sch]
2017-05-03 schematics and parts list
    [motorcontrol.sch, pcb_parts.xlsx]
2017-05-03 Revert "schematics and parts list"
    This reverts commit 655633203b17579b9a6b4deefc9c625c85ada2bd.
    [motorcontrol.sch, pcb_parts.xlsx]
2017-05-03 Revert "Revert "schematics and parts list""
    This reverts commit 970b9175388dfda417d99c9230ef583c3620850f.
    [motorcontrol.sch, pcb_parts.xlsx]
2017-05-08 motorcontrol schematic should be ready
    [motorcontrol.brd, motorcontrol.sch]
2017-05-09 Added CAD instructions
2017-05-11 added LED datasheet
2017-05-12 hall effect sensor datasheet
2017-05-13 all planes set, last commit before autoroute
    [motorcontrol.brd]
2017-05-13 board is completely routed and checked
    [motorcontrol.brd]
2017-05-13 names moved to final positions
    [motorcontrol.brd, motorcontrol.sch]
2017-05-13 labels and text in place
    [motorcontrol.brd, motorcontrol.sch]
2017-05-13 fixed font in top board layer
    [motorcontrol.brd]
2017-05-13 fixed camera cable slot dimensions, there was nothing right about them (didn't follow pihat standard, didn't work for oshpark)
    [motorcontrol.brd]
2017-05-14 updated schematic with new INH control
    [motorcontrol.brd, motorcontrol.sch]
2017-05-14 rerouted INH signals
    [motorcontrol.brd, motorcontrol.sch]
2017-05-14 added Sunstone Gerbers
    [picar.drl]
2017-05-14 minor font change
    [motorcontrol.sch]
2017-05-15 added Sunstone CAM files, eagle's BOM
    [eagle_bom.csv]
2017-05-15 cut out is gone, long live the snake border
    [motorcontrol.brd]
2017-05-15 updated gerbers
2017-05-15 motor control
2017-05-15 Create ArduinoAPI
2017-05-15 moved arduino API doc to docs folder
2017-05-15 moved motorcontrol arduino code to correct folder
2017-05-15 moved SPI code to arduino folder
2017-05-15 moved optical flow code to pi folder
2017-05-15 optical flow code
2017-05-17 Servo Dshare added
2017-05-17 Servo Dshare Pi side added
2017-05-17 built servo executable
2017-05-18 moved files to make Arduino IDE happy. Added avrfix.pdf thesis
2017-05-18 fixed header function declarations
    [arduino.ino, ddefs.h, dshare.c, dshare.h, imu.h]
2017-05-18 added PID library
2017-05-18 motorcontrol with interrupts
2017-05-18 fixed merge corruption, autoformatted all source files
    [arduino.ino, avrfix.c, avrfix.h, avrfix_config.h, ddefs.h, dshare.c, dshare.h, imu.h]
2017-05-18 created fixed point wrapper header, updated PID code
    [fp.h]
2017-05-18 motorcontrol read hall sensors
2017-05-18 improved PID code, added second order Butterworth IIR filter
2017-05-19 bldc interrupt
2017-05-19 pcb bldc
2017-05-20 added pdfs to help with assembly
2017-05-20 minor cosmetic changes to board
    [motorcontrol.brd, motorcontrol.sch]
2017-05-20 Added RPMtoPWM function
    Haven't implemented PID yet.
2017-05-20 added IMU library
2017-05-20 added imu code
2017-05-20 added SPI interrupts
2017-05-20 moved imu library files
2017-05-20 Renamed to speed_control
    Input - RPM_desired
    Output - PWM
    Haven't implemented PID
2017-05-20 Fixed implicit function declarations
    [speed_control.c]
2017-05-20 spi communication edits
2017-05-21 fixing imu c issue
    [arduino.ino, imu.c, imu.h, servocontrol.c, servocontrol.h, timers.c]
2017-05-21 imu.cpp code moved to Sparkfun's imu driver
2017-05-21 renamed Sparkfun's driver to simply imu
2017-05-21 imu does not compute float version of biases
2017-05-21 changed included header to imu.h
2017-05-21 removed shady imu calibration constant
2017-05-21 added PID windup protection, other minor changes
2017-05-21 changed imu code to read ints into main data structure
2017-05-22 reenabled interrupts in PCB_BLDC code
2017-05-22 reorganization eagle files
    [BOM.csv, eagle_bom.csv, motorcontrol.brd, motorcontrol.sch, pcb.sch, pcb_parts.xlsx, rpibout.brd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]
2017-05-22 added arduino optical flow demo code
2017-05-22 small update to servo spi test
2017-05-22 list of changes for board items
    [motorcontrol.sch]
2017-05-22 creating python spi protocol
2017-05-22 python spi test from arduino side
2017-05-22 python spi from pi side
2017-05-24 new schematic is ready
    [motorcontrol.brd, motorcontrol.sch]
2017-05-24 fixed RPi-Arduino buffer for reset pin
    [motorcontrol.brd, motorcontrol.sch]
2017-05-25 modified arduino spi test
2017-05-25 updated optical flow close loop test
2017-05-25 added new SPI procedure to main arduino file
2017-05-25 updated layer display in v2.0 board
    [motorcontrol.brd]
2017-05-26 bldc test
2017-05-26 pcb test
2017-05-26 before autoroute
    [motorcontrol.brd, motorcontrol.sch]
2017-05-27 added PID controller for servo angle
2017-05-27 new bldc test
2017-05-27 fixed PWM to zero bug
2017-05-27 Updated PCB
2017-05-28 implemented PI pwm controller, start condition
2017-05-28 updated PCB_test
2017-05-28 added bldc_enable bit
2017-05-28 added kill switch test
2017-05-28 PCB SPI testing added
2017-05-29 minor arduino changes
2017-05-29 copied arduino file to make arduino leonardo file
    [COMMUTATION.xlsx]
2017-05-29 deleted leonardo file
    [COMMUTATION.xlsx]
2017-06-01 routed board
    [motorcontrol.brd]
2017-06-01 board is ready
    [motorcontrol.brd, motorcontrol.sch]
2017-06-02 final minor changes, added PDFs with board and schematic
    [motorcontrol.brd, motorcontrol.sch]
2017-06-02 added BOM, minor package upgrades
    [motorcontrol-bom.csv, motorcontrol.sch]
2017-06-02 moved motorcontrol v2.1 to its own folder
    [motorcontrol-bom.csv, motorcontrol.brd, motorcontrol.sch]
2017-06-03 fixed error in connection between IS U3 and ATADC4
    [motorcontrol.brd, motorcontrol.sch]
2017-06-03 reorganized names in board
    [motorcontrol.brd]
2017-07-01 Created gerber files
    Used gerb274x-4layer.cam file as recommened by Advanced Circuits (4pcb)
2017-07-03 increased global PCB clearance to 6 mil
    [motorcontrol.brd]
2017-12-21 PCB code update
2017-12-21 PCB code test
2018-03-06 print status
2018-04-04 alias commit
    [timingData.csv]
2018-04-11 feature matching and keypoint finder abstraction
    [timingData.csv]
2018-04-16 report generator, data acquisition, error calculations, lots of minor edits
    [test.csv, timingData.csv, trueBasketballData.csv, trueBottleData.csv]
2018-04-16 report generator finished
    [test.csv, timingData.csv]
2018-04-30 cleaned up optical flow code
2018-04-30 restructured CV code, removed unused tracking files
    [trueBasketballData.csv, trueBottleData.csv]
2018-04-30 renamed folder
    [trueBasketballData.csv, trueBottleData.csv]
2018-05-22 updated Linux tutorial, Mechanical docs, and fixed formatting
    [bill_of_materials.csv]
2018-05-22 I2C communication docs
2018-05-23 PI to IMU implemented and documented
2018-05-24 Pi and Lidar Communication
2018-05-25 new i2c-dev file
2018-06-01 added github button, added motor_feedback_control arduino code in src/arduino
2018-06-01 datasheet/socket code usage under software
2018-06-02 add IMU communication by LSM9DS1 Libray
2018-06-04 add sensors reading,writing and camera usage
2018-06-07 updated 'results' with imu_nav and power_mgmt reports
2018-06-07 version1 timer
    [sensorData.csv, timer_accuracy.csv]
2018-06-07 add sensor/camera concurrent reading by timer
    [timer_accuracy.csv]
2018-06-08 added Optical Flow to results
2018-06-12 update SPI tutorial between pi and arduino
2018-06-15 IMU setting enabled Delta timing Lidar IMU implemented socket video stream implemented
2018-06-17 i2c by GPIO, sending float by i2c
2018-06-20 Serial communication between pi and arduino, organized documentation
2018-06-22 spi communication updated, tfmini lidar usage updated
2018-06-22 socket folder transfer documented
2018-06-27 Internet section added server code in IMU folder
2018-07-03 sensors change to devices finished with help message
2018-07-06 Adding the WASD arduino and pi code to github
2018-07-09 Updated WASD Code with incremental steering and command control times
2018-07-12 data sychronization and display documentation
    [Lidar_IMU_Data.csv, long-sample.csv, sample.csv, sync_data_712.csv, verylong-sample.csv]
2018-07-13 folder organized pmu refined
    [trueBasketballData.csv, trueBottleData.csv]
2018-07-18 update data plot and i2c bus0 usage
2018-07-19 devices_int to picar change module dependency
2018-07-30 fixed computer_vision code and moved from obsolete to src/pi
    [trueBasketballData.csv, trueBottleData.csv]
2018-09-04 updated mechanical assembly docs
2018-10-10 Fixed documentation and organized old code
    [BOM.csv, Bottom Motor Holder.step, Bottom Motor Holder.stl, Camera Post.step, Camera Post.stl, Chassis.step, Chassis.stl, Encoder Holder.step]
2019-01-02 fixed docs
    [bill_of_materials.csv]
